polymech-info/heidenhain-simulator/cli/cad/docs/Spec.md

## OSR - CAD Policies

### Assemblies

- **Valid Formats** : STEP, Solidworks, Parasolid
