polymech-info/heidenhain-simulator/docs/670_388-20_images/670_388-20_9.md

# New Functions of Software
340 49x-03
ref_text
■ New cycle for setting a datum in the center of a slot (see "SLOT CENTER REF PT (Cycle 408, DIN/ISO: G408, FCL 3 function)" on page 333)
ref_text
■ New cycle for setting a datum in the center of a ridge (see "RIDGE CENTER REF PT (Cycle 409, DIN/ISO: G409, FCL 3 function)" on page 337)
ref_text
■ New 3-D probing cycle (see "MEASURING IN 3-D (Cycle 4, FCL 3 function)" on page 439)
ref_text
- Cycle 401 now also allows you to compensate workpiece misalignment by rotating the rotary table (see “BASIC ROTATION from two holes (Cycle 401, DIN/ISO: G401)” on page 313)
- Cycle 402 now also allows you to compensate workpiece misalignment by rotating the rotary table (see “BASIC ROTATION over two studs (Cycle 402, DIN/ISO: G402)” on page 316)
- In the cycles for datum setting, the results of measurement are available in the Q parameters Q15X (see “Measurement results in Q parameters” on page 387)

HEIDENHAIN iTNC 530
9

i
