polymech-info/heidenhain-simulator/cli/cad/tests/cas/cad/press-plate-support/400_Pressplate-lower-support.SLDASM

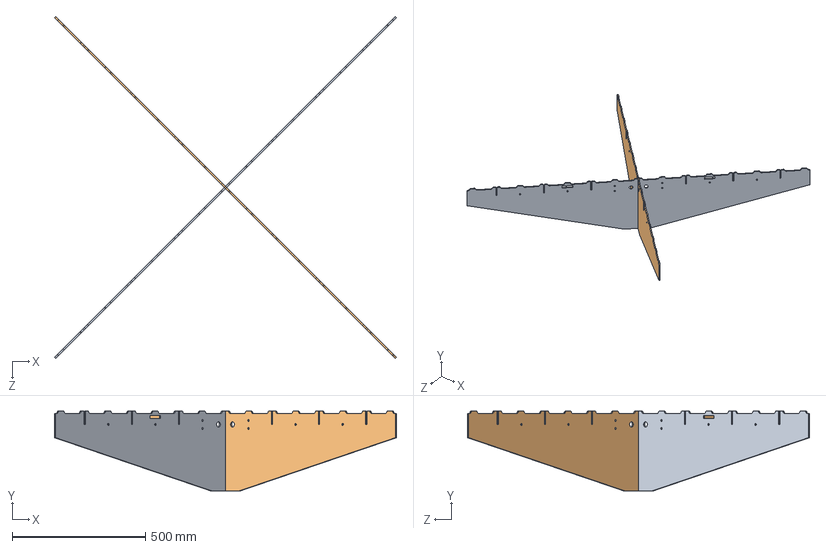
[picture p4: CAD file, 2026-09-25]
cli/cad/tests/cas/cad/press-plate-support/400_Pressplate-lower-support.SLDASM
1284.0 x 300.0 x 1284.1 mm
200_RIBA1_x1_6mm_FERRO
200_RIBA1B_x1_6mm_FERRO
