polymech-info/heidenhain-simulator/cli/cad/tests/cas/cad/sideframe/SideFrameAssembly.SLDASM

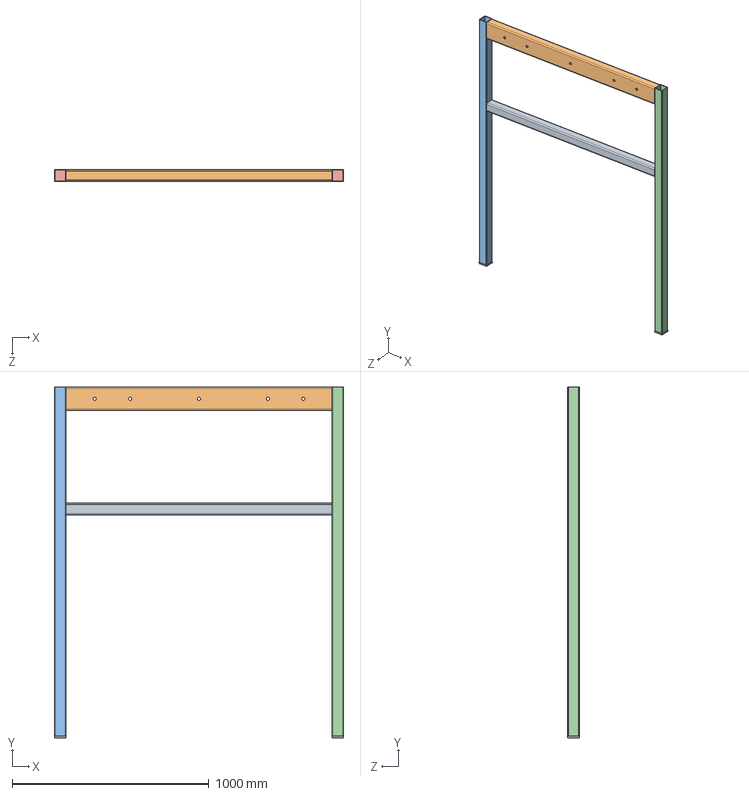
[picture p5: CAD file, 2026-09-25]
cli/cad/tests/cas/cad/sideframe/SideFrameAssembly.SLDASM
1470.0 x 1783.0 x 60.0 mm
Side Frame Midrail 80x40x840mm
303_SideFrameToprail
Leg with hood bracket cut
MirrorLeg with hood bracket cut
400_LegCover_x4_10mm_FERRO x 2
