polymech-info/heidenhain-simulator/fusion-ref/moulds/beams/Global-180x80x25_Assembly_0 v1/geometry/Global-180x80x25_Assembly_0 v1.step

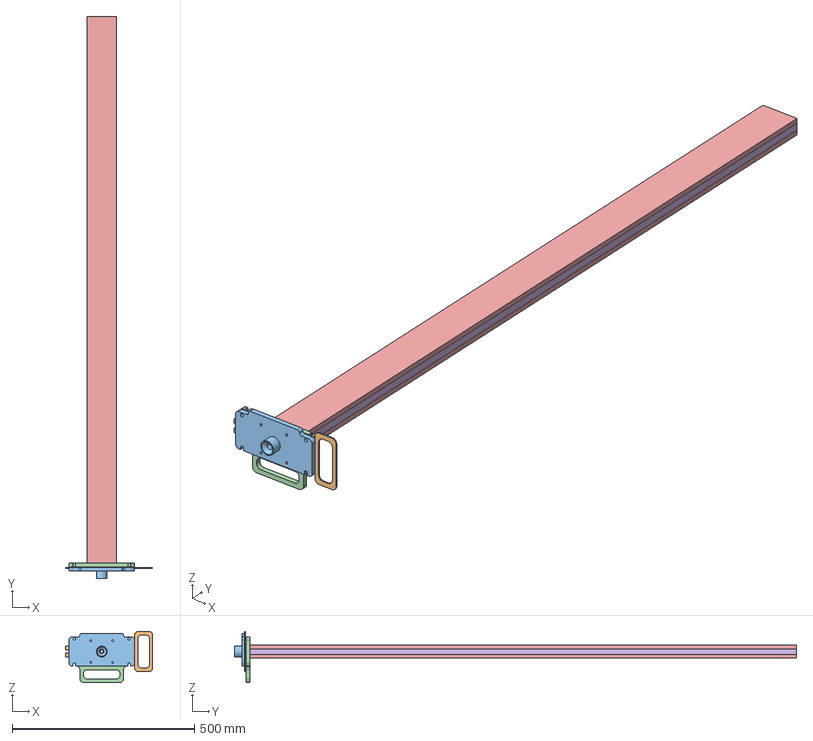
[picture p7: CAD file, 2026-09-25]
fusion-ref/moulds/beams/Global-180x80x25_Assembly_0 v1/geometry/Global-180x80x25_Assembly_0 v1.step
240.0 x 1542.0 x 140.0 mm
402_SlideCover_x2_2mm_INOX
403_SlideKey_x1_2mm_INOX
450_BeamAdapter_x1_10mm_FERRO
450_BeamMountPlate_x2_8mm_FERRO
101_Top_x2_8mm_FERRO x 2
101_Sides_x2_16mm_FERRO x 2
