polymech-info/heidenhain-simulator/fusion-ref/moulds/thomas/mould-assembly-2 v1/geometry/mould-assembly-2 v1.step

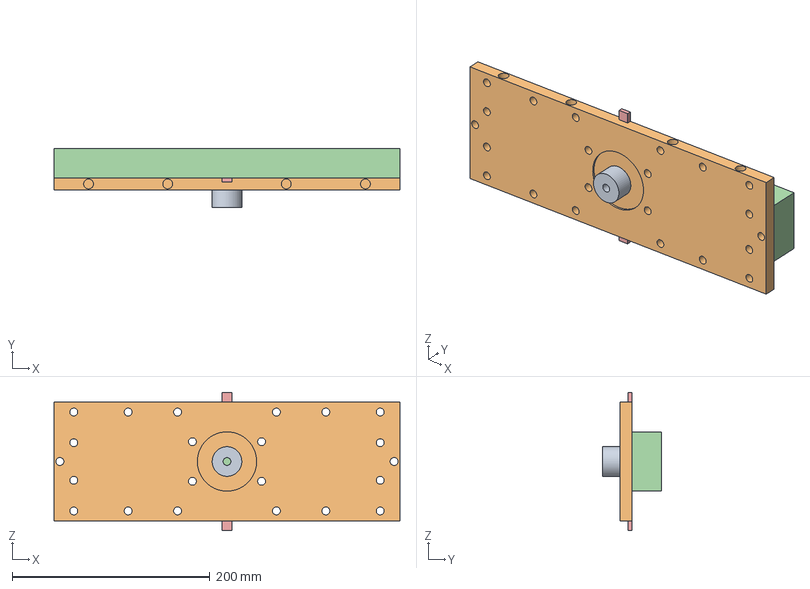
[picture p9: CAD file, 2026-09-25]
fusion-ref/moulds/thomas/mould-assembly-2 v1/geometry/mould-assembly-2 v1.step
350.0 x 60.0 x 140.0 mm
Lydia-F100-ConnectorPlate-130x130_Lydia-V3-100F
bar x 2
Bars-Upper
valve
