polymech-info/heidenhain-simulator/cli/cad/tests/cas/cad/lower-support/Global.SLDASM

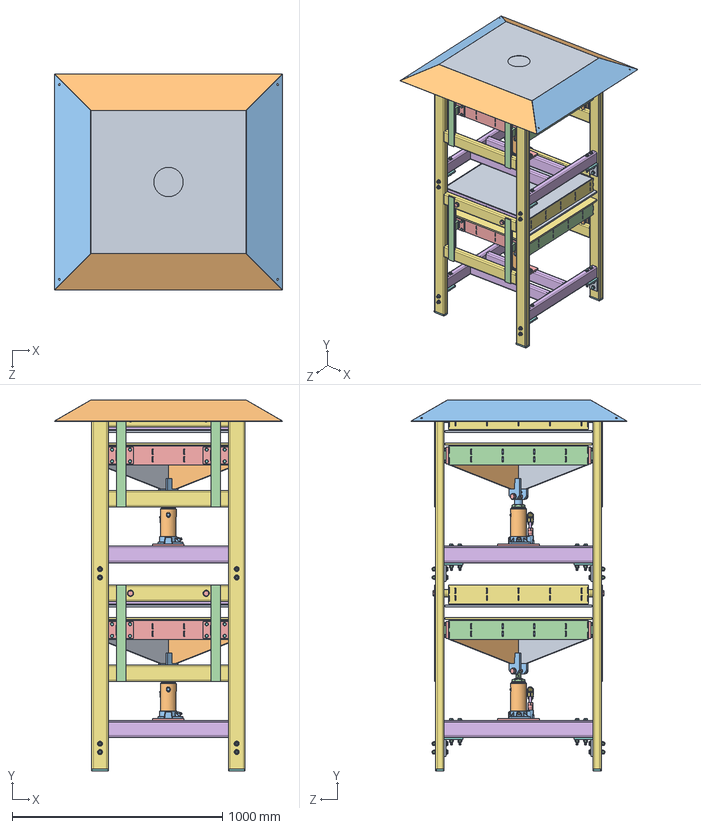
[picture p10: CAD file, 2026-09-25]
cli/cad/tests/cas/cad/lower-support/Global.SLDASM
1086.4 x 1764.3 x 1028.7 mm
HeatPlate x 2
19_Crossrib_x10_5mm_FERRO x 12
21_HeaterPlate_x8_5mm_FERRO x 8
Heater Block x 82
Heatproof Puck x 82
18_Endpanel_x4_5mm_FERRO x 4
17_Sidepanel_x4_5mm_FERRO x 4
20_Rib_x10_5mm_FERRO x 12
200_PPlateCover_x2_1mm_INOX x 2
8_Rib_x8_5mm_FERRO.DXF x 8
7_Rib_x8_5mm_FERRO.DXF x 8
7_Side_x4_5mm_FERRO.DXF x 4
6_Side_x4_5mm_FERRO.DXF x 4
10_HeaterBack_x10_5mm_FERRO.DXF x 10
EMP_054_Heatplate_Light_x2_10.0mm_Inox x 2
EMP_058_Heatplate_Mount_Light_x4_10.0mm_Inox x 2
1_RibA_x1_10mm_FERRO x 2
2_RibB_x1_10mm_FERRO x 2
3_Mount_x2_10mm_FERRO x 4
SBR20UU x 8
11_Mount_x8_10mm_FERRO x 8
socket countersunk head screw_din x 32
plain washer grade a_din x 32
hex bolt gradeb_din x 64
201_PlateCoverTri_x8_1mm_FERRO x 8
SBS 20 Rail 200mm x 8
Bottle Jack Base x 2
Valve Ball x 4
Pump washer-gasket x 2
Plastic Stop x 2
Valve Bolt x 2
Valve Bolt Dowel x 2
O-Ring - 11 OD x 2
Jack Barrel x 2
Jack Piston x 2
Power Screw x 2
Jack Piston - O-Ring x 2
Jack Piston - Back-up Ring x 2
Pump Lever x 2
Pump Lever Linkage Connector Pin x 2
reinforced e-ring external retaining ring_am x 10
Pump Lever Main Connector Pin x 2
Pump Lever Linkage x 4
Pump Lever Linkage Base Connector Shaft x 2
Pump Barrel x 2
Pump Piston x 2
Pump Barrel - Gasket x 2
Pump Piston - O-Ring x 2
Pump - Back-up Ring x 2
Bottle Jack Housing x 2
Rubber Relief-Filler x 2
Retaining Nut x 2
15_JMPlate_x1_10mm_FERRO x 2
Bottom Frame x 2
Side Frame x 2
30_Bracket1_x8_10mm_FERRO x 8
31_Bracket2_x8_10mm_FERRO x 8
plain washer 6902 type abc_din x 64
plain washer grade c_din x 20
prevailing torque nut style 1 insert_din x 34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
