polymech-info/heidenhain-simulator/cli/cad/tests/cas/cad/press-frame-2/Lower Platen Matrix Assembly Light.SLDASM

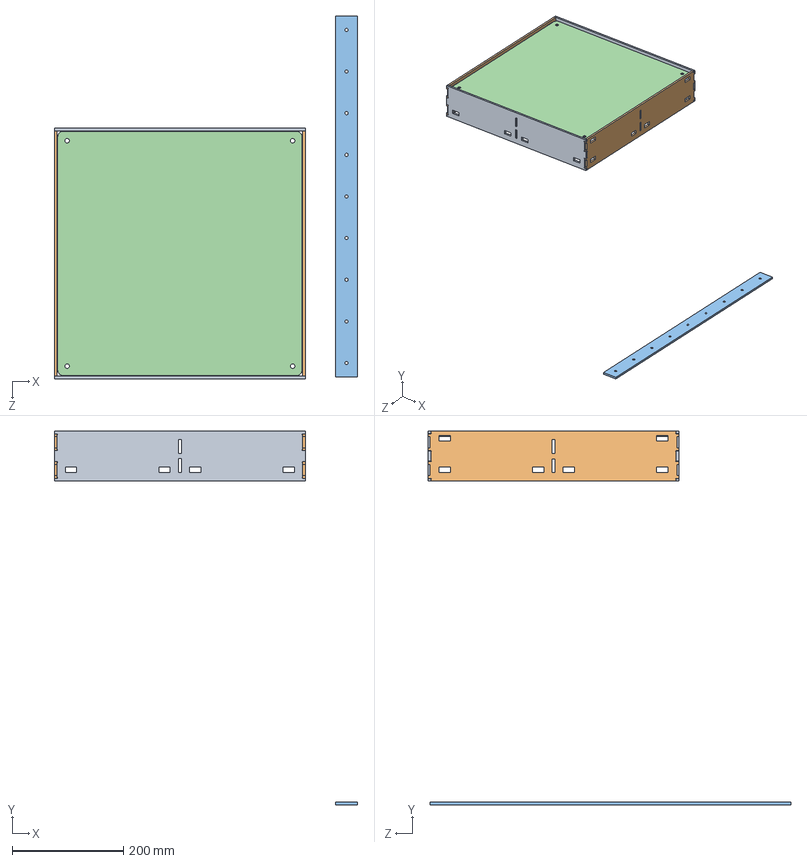
[picture p11: CAD file, 2026-09-25]
cli/cad/tests/cas/cad/press-frame-2/Lower Platen Matrix Assembly Light.SLDASM
546.1 x 673.2 x 653.7 mm
7_Side_x4_5mm_FERRO.DXF x 2
6_Side_x4_5mm_FERRO.DXF x 2
202_PlateCover_x2_1mm_INOX
