polymech-info/heidenhain-simulator/cli/cad/tests/cas/cad/lower-structure/Lower-Structure.SLDASM

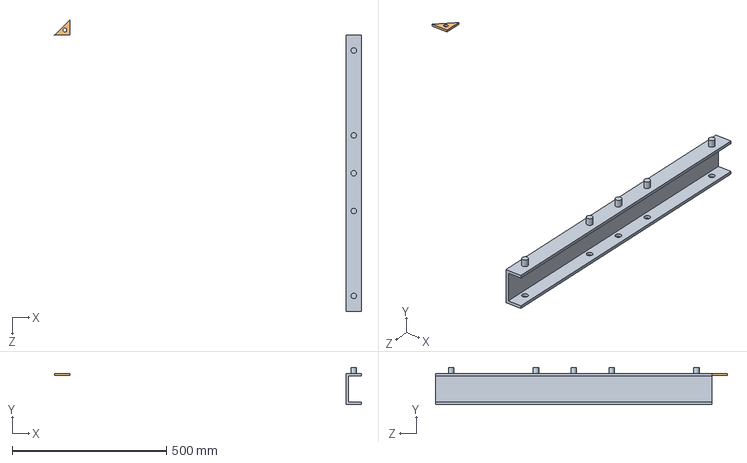
[picture p12: CAD file, 2026-09-25]
cli/cad/tests/cas/cad/lower-structure/Lower-Structure.SLDASM
995.0 x 120.0 x 945.0 mm
Beam
Part1^Lower-Structure
