polymech-info/heidenhain-simulator/cli/cad/tests/cas/cad/press-plate-support/301_LowerRibs.SLDASM

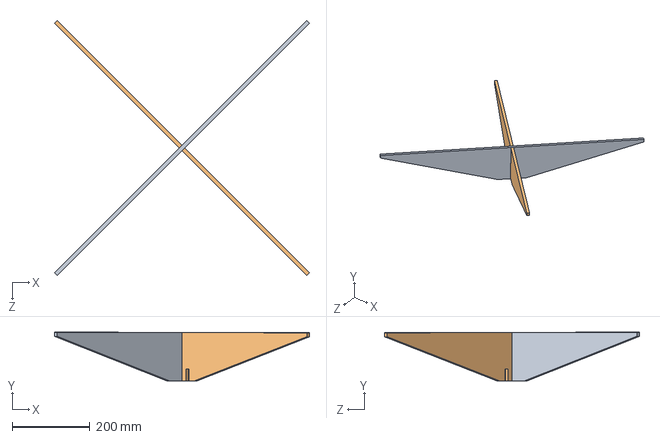
[picture p13: CAD file, 2026-09-25]
cli/cad/tests/cas/cad/press-plate-support/301_LowerRibs.SLDASM
658.0 x 126.2 x 658.0 mm
302_RibA_x1_10mm_FERRO
302_RibB_x1_10mm_FERRO
