polymech-info/heidenhain-simulator/cli/cad/tests/cabinet/EDC-Tests.SLDASM

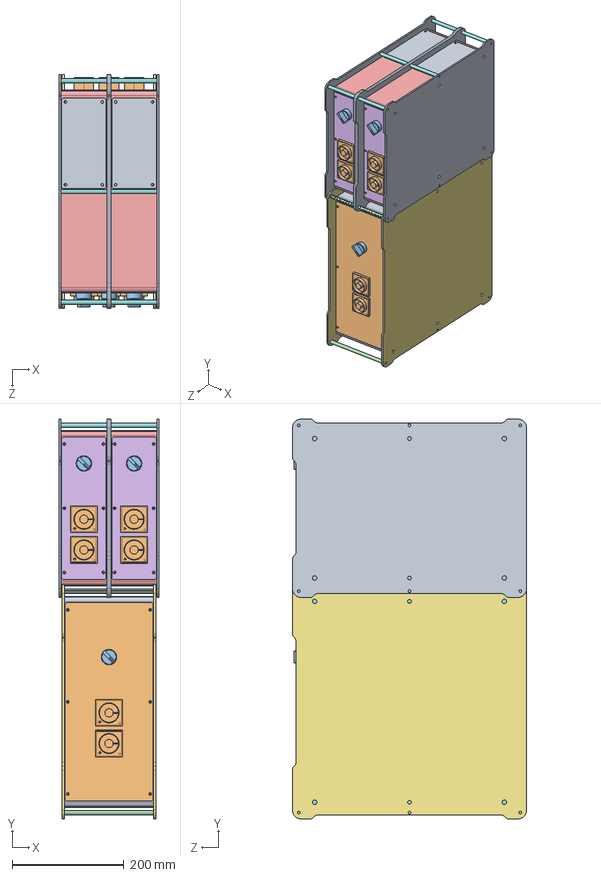
[picture p14: CAD file, 2026-09-25]
cli/cad/tests/cabinet/EDC-Tests.SLDASM
180.0 x 717.0 x 420.0 mm
403_MountPlate_x2_4mm_INOX x 4
E5C2 x 6
3Pos-Switch-22mm x 3
530_BasePost x 12
525_Belt_x1_1mm_INOX x 2
610_FrontPanel_x1_1mm_INOX x 2
611_BackPanel_x2_1mm_INOX x 4
540_SupportHookPins_x6_8mm_INOX x 12
612_SidePanel_x2_1mm_INOX x 4
MCB-2P x 6
Circuit breaker Schneider Electric BA63.STEP x 3
Plastic overlay.STEP x 3
Latch.STEP x 3
Lever arm.STEP x 3
803_MountPlate_x2_4mm_INOX x 2
830_BasePost x 6
825_Belt_x1_1mm_INOX
810_FrontPanel_x1_1mm_INOX
811_BackPanel_x2_1mm_INOX x 2
840_SupportHookPins_x6_8mm_INOX x 6
812_SidePanel_x2_1mm_INOX x 2
