polymech-info/heidenhain-simulator/cli/cad/tests/cabinet/packed/CAM-SidePanel.SLDASM

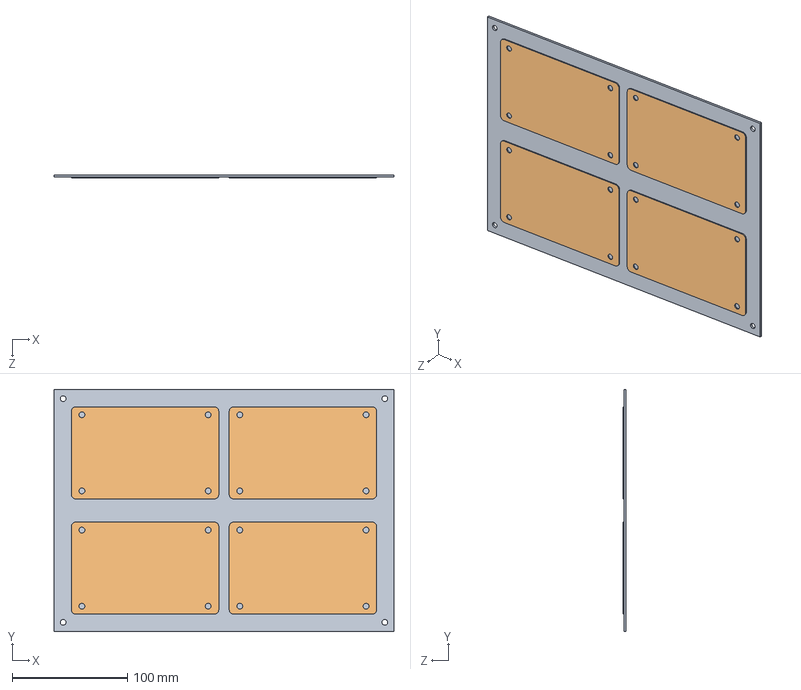
[picture p15: CAD file, 2026-09-25]
cli/cad/tests/cabinet/packed/CAM-SidePanel.SLDASM
295.0 x 210.0 x 3.00 mm
Panels-Sheet-Stock-A4
611_BackPanel_x2_1mm_INOX x 4
