polymech-info/heidenhain-simulator/cli/cad/tests/cas/cad/400_Pressplate-lower-support.SLDASM

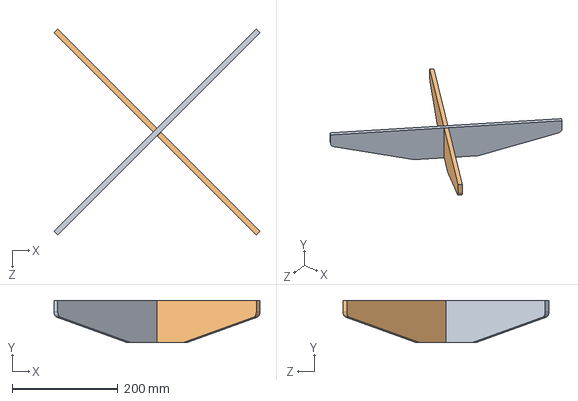
[picture p16: CAD file, 2026-09-25]
cli/cad/tests/cas/cad/400_Pressplate-lower-support.SLDASM
390.0 x 80.0 x 390.1 mm
200_RIBA1_x2_10mm_FERRO
200_RIBA1B_x2_10mm_FERRO
