polymech-info/heidenhain-simulator/cli/cad/tests/cas/cad/press-frame-2/200_Bottom-PressPlate.SLDASM

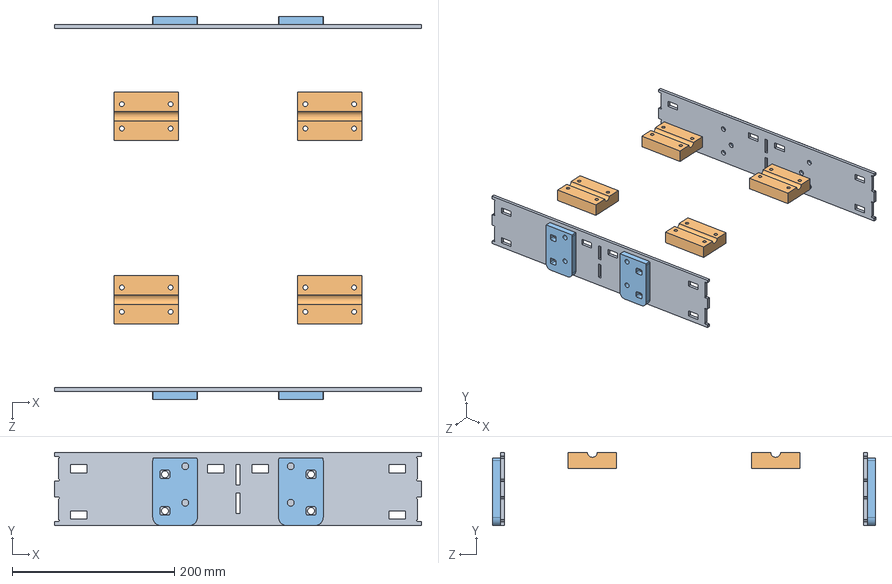
[picture p17: CAD file, 2026-09-25]
cli/cad/tests/cas/cad/press-frame-2/200_Bottom-PressPlate.SLDASM
452.0 x 90.0 x 471.8 mm
7_Side_x2_5mm_FERRO.DXF x 2
405_BearingMount_x8_8mm_FERRO x 4
