polymech-info/heidenhain-simulator/cli/cad/tests/cas/cad/sideframe/GlobalAssembly.SLDASM

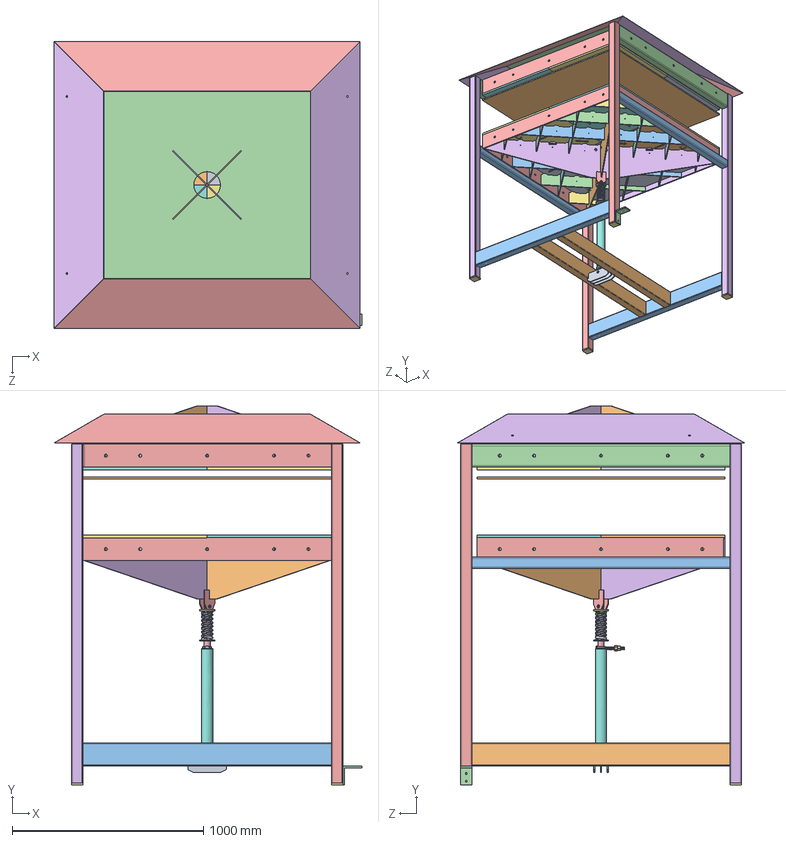
[picture p18: CAD file, 2026-09-25]
cli/cad/tests/cas/cad/sideframe/GlobalAssembly.SLDASM
1611.0 x 1983.0 x 1502.0 mm
26_JackMount_x3_6mm_Ferro x 4
Base Frame Crossmember x 2
Base Frame Rail x 2
SPR-V1 4000.01-A Spring sleeve
SPR-V1 4000.02-A Spring rod
SPR-V1 4000.012 Spring flange upper
SPR-V1 4000.01 Spring flange lower
SPR-V1 15 Die Spring_96485K331
hex nut gradec_iso_ISO - 4034 - M16 - N x 2
hex bolt gradeab_iso_ISO 4014 - M16 x 140 x 140-S
SPR-V1 01 Jack rod
SP1.0_025_Jack_Mount Upper_x2_6.0mm_Inox x 2
200_RIBA1_x1_6mm_FERRO x 2
200_RIBA4_x4_6mm_FERRO x 8
200_RIBA2_x2_6mm_FERRO x 4
200_RIBA3_x2_6mm_FERRO x 4
200_RIBA1B_x1_6mm_FERRO x 2
200_RIBA2B_x2_6mm_FERRO x 4
200_RIBA3B_x2_6mm_FERRO x 4
300_BAR_x4_8mm_FERRO x 6
MirrorPlaten End x 2
sp-partition-tl x 2
sp-partition-tr x 2
sp-partition-bl x 2
sp-partition-br x 2
Side Frame Midrail 80x40x840mm x 2
303_SideFrameToprail x 2
Leg with hood bracket cut x 2
MirrorLeg with hood bracket cut x 2
400_LegCover_x4_10mm_FERRO x 4
SPR-V1 01 Cylinder
400_Mount_4x_6mm_FERRO
603_Centerpanel_x1_2mm_Ferro
602_Endpanel_x1_2mm_Ferro x 2
604_Sidepanel_x1_2mm_Ferro x 2
