polymech-info/heidenhain-simulator/cli/cad/tests/cabinet/CAB-2PID-VintageVertical.SLDASM

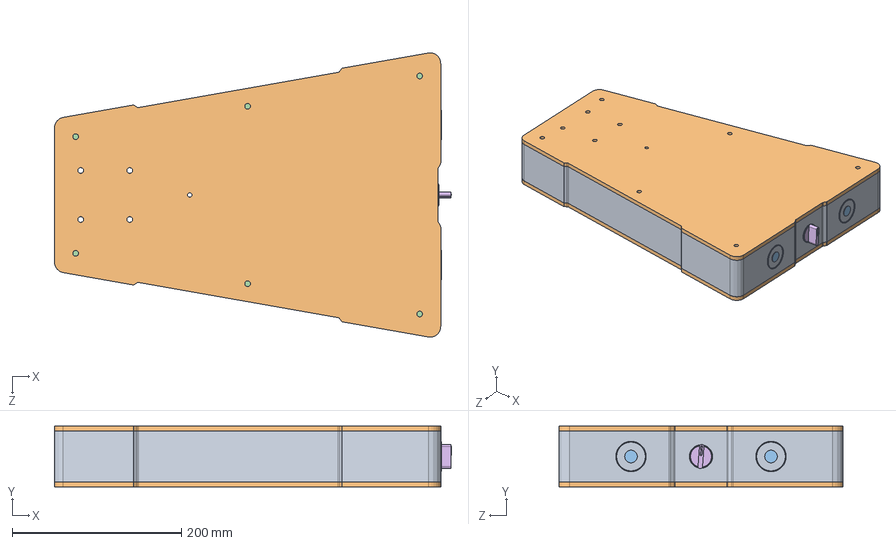
[picture p19: CAD file, 2026-09-25]
cli/cad/tests/cabinet/CAB-2PID-VintageVertical.SLDASM
469.7 x 72.0 x 336.3 mm
520_Belt_x2_1mm_INOX
403_MountPlate_x2_6mm_INOX x 2
E5C2 x 2
530_BasePost x 6
540_MiddlePlate_x2_1mm_INOX x 2
3Pos-Switch-22mm
socket button head cap screw_amxxx x 6
