polymech-info/heidenhain-simulator/cli/cad/tests/cas/cad/press-frame/TopPress-Plate.SLDASM

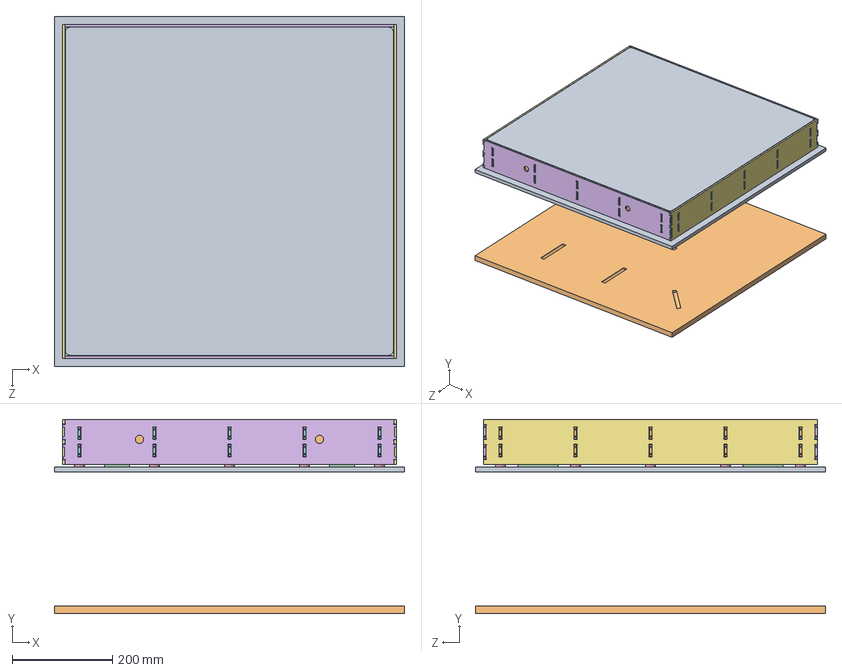
[picture p20: CAD file, 2026-09-25]
cli/cad/tests/cas/cad/press-frame/TopPress-Plate.SLDASM
700.0 x 388.6 x 700.0 mm
19_Crossrib_x10_5mm_FERRO x 6
Heater Block
Heatproof Puck x 25
18_Endpanel_x4_5mm_FERRO x 2
17_Sidepanel_x4_5mm_FERRO x 2
20_Rib_x10_5mm_FERRO x 6
200_PPlateCover_x2_1mm_INOX
sp-artition-cell
