polymech-info/heidenhain-simulator/cli/cad/tests/cabinet/packed/Cabinet-EDC-Flex.SLDASM

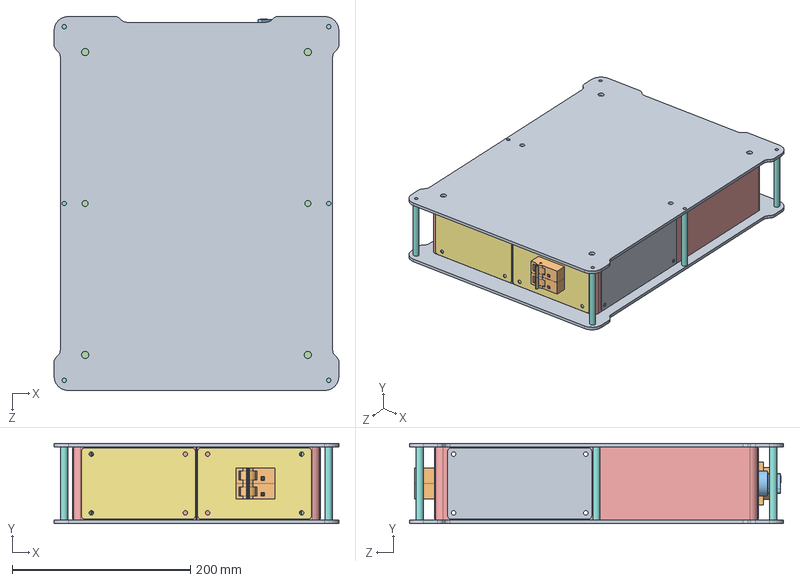
[picture p21: CAD file, 2026-09-25]
cli/cad/tests/cabinet/packed/Cabinet-EDC-Flex.SLDASM
320.0 x 90.0 x 420.0 mm
403_MountPlate_x2_4mm_INOX x 2
E5C2 x 2
3Pos-Switch-22mm
530_BasePost x 6
525_Belt_x1_1mm_INOX
610_FrontPanel_x1_1mm_INOX
611_BackPanel_x2_1mm_INOX x 2
540_SupportHookPins_x6_8mm_INOX x 6
612_SidePanel_x2_1mm_INOX x 2
MCB-2P x 2
Circuit breaker Schneider Electric BA63.STEP
Plastic overlay.STEP
Latch.STEP
Lever arm.STEP
