polymech-info/heidenhain-simulator/cli/cad/tests/cabinet/500_Base.SLDASM

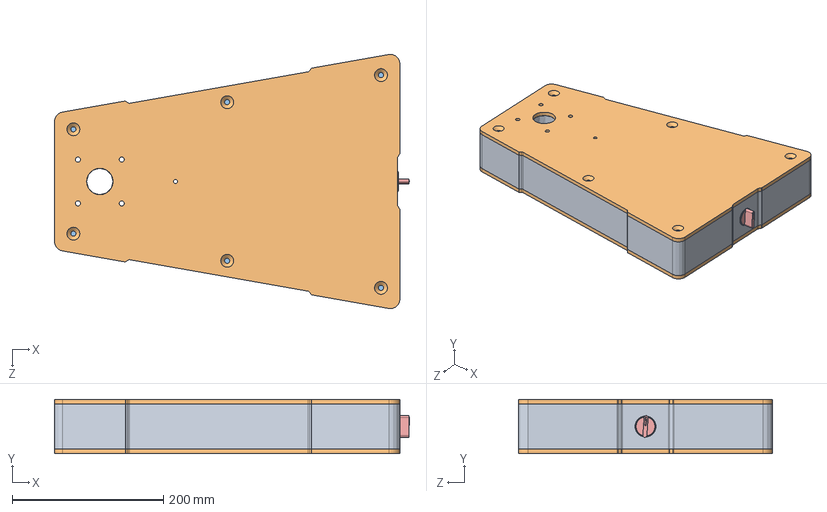
[picture p22: CAD file, 2026-09-25]
cli/cad/tests/cabinet/500_Base.SLDASM
469.7 x 72.0 x 336.3 mm
520_Belt_x2_1mm_INOX
403_MountPlate_x2_5mm_INOX x 2
530_BasePost^500_Base x 6
540_MiddlePlate_x2_1mm_INOX x 2
3Pos-Switch-22mm
