polymech-info/heidenhain-simulator/cli/cad/tests/cas/cad/600_Enclosure.SLDASM

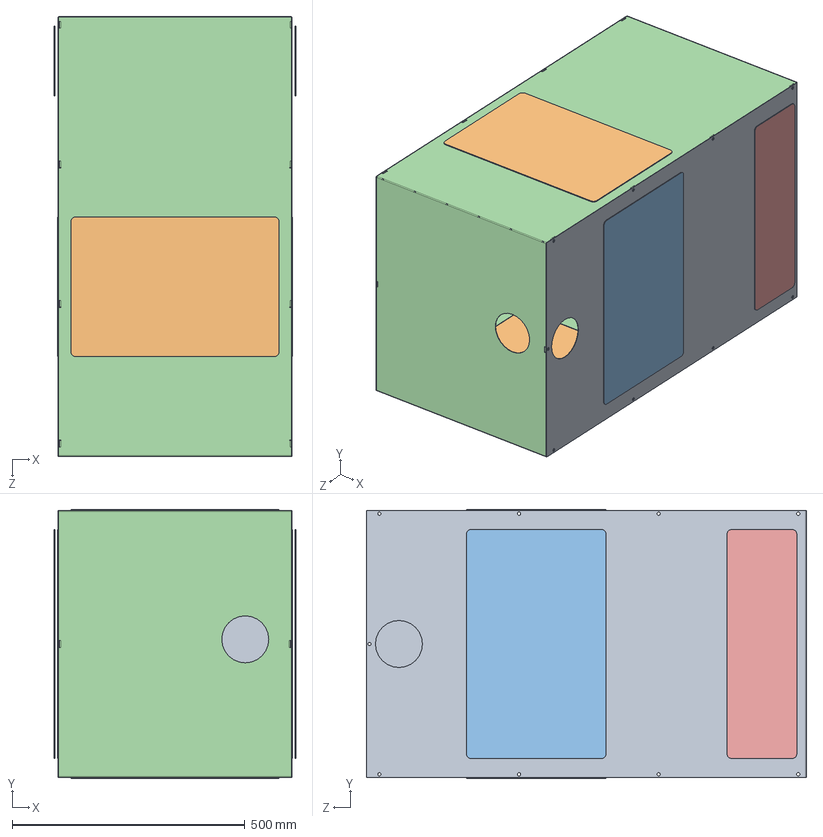
[picture p23: CAD file, 2026-09-25]
cli/cad/tests/cas/cad/600_Enclosure.SLDASM
519.5 x 578.0 x 946.0 mm
102_Bottom2_x1_2mm_INOX
502_SideDoor_x2_2mm_INOX x 2
501_FrontDoor_x2_2mm_INOX x 2
102_Top_2mm_INOX
504_BottomDoor_x2_2mm_INOX x 2
