polymech-info/heidenhain-simulator/cli/cad/tests/cas/cad/Framework.SLDASM

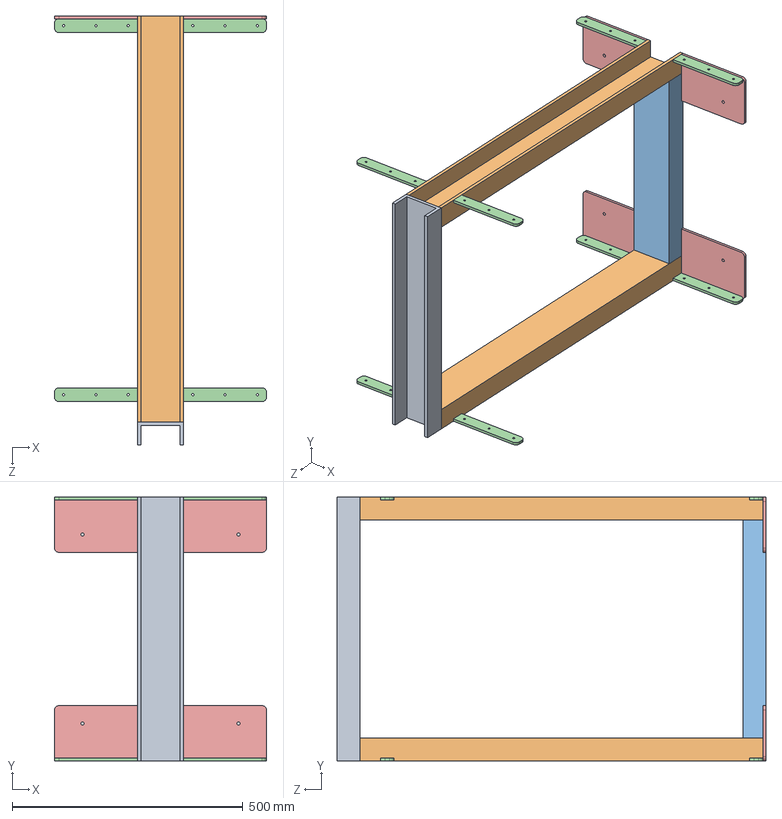
[picture p24: CAD file, 2026-09-25]
cli/cad/tests/cas/cad/Framework.SLDASM
460.0 x 572.0 x 930.0 mm
100_50_BeamTop
100_50_Beam x 2
100_50_BeamBottom
801_EncTopMount_x4_5mm_FERRO x 8
802_EncBottomMount_x4_6mm_FERRO x 4
