polymech-info/heidenhain-simulator/cli/cad/tests/cabinet/540_SupportHookPins_x6_8mm_INOX.SLDPRT

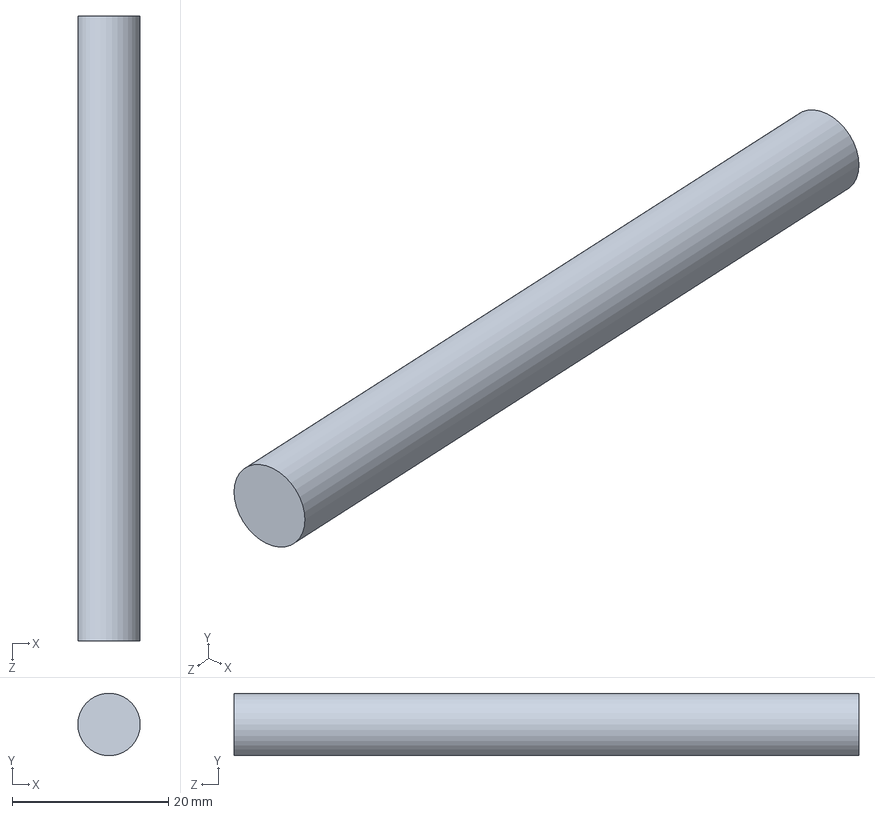
[picture p25: CAD file, 2026-09-25]
cli/cad/tests/cabinet/540_SupportHookPins_x6_8mm_INOX.SLDPRT
8.00 x 7.97 x 80.0 mm
