polymech-info/heidenhain-simulator/cli/cad/tests/cas/cad/504_BottomDoor_x2_2mm_INOX.SLDPRT

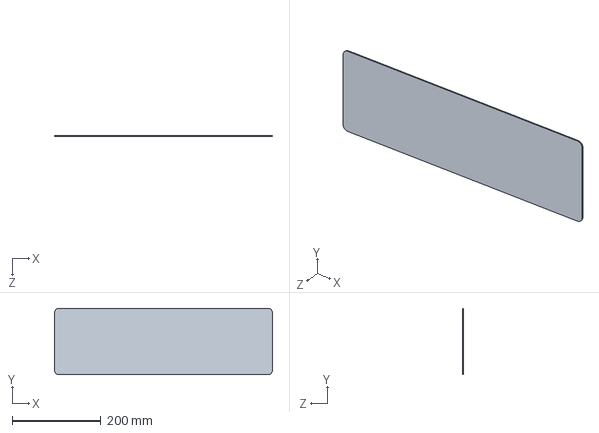
[picture p26: CAD file, 2026-09-25]
cli/cad/tests/cas/cad/504_BottomDoor_x2_2mm_INOX.SLDPRT
492.0 x 150.0 x 2.00 mm
