polymech-info/heidenhain-simulator/cli/cad/tests/cas/cad/enclosure/102_Top_2mm_INOX.SLDPRT

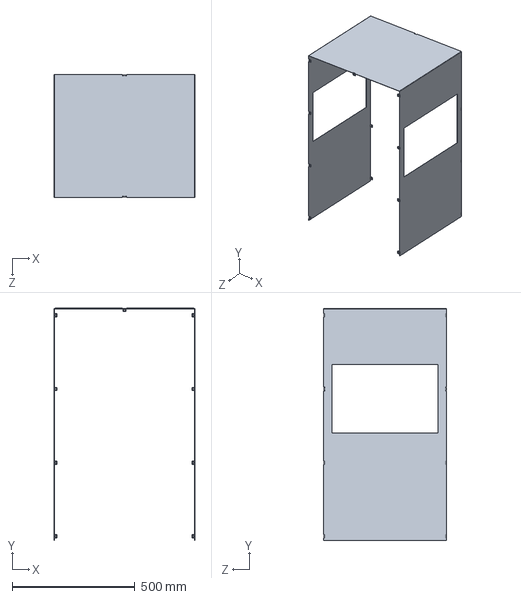
[picture p27: CAD file, 2026-09-25]
cli/cad/tests/cas/cad/enclosure/102_Top_2mm_INOX.SLDPRT
574.0 x 945.0 x 500.0 mm
