polymech-info/heidenhain-simulator/cli/cad/tests/cas/cad/enclosure/laser/102_Bottom2_x1_2mm_INOX.DXF

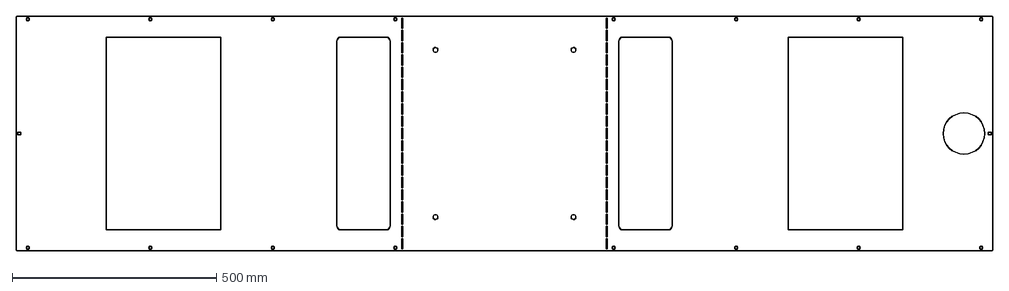
[picture p28: CAD file, 2026-09-25]
cli/cad/tests/cas/cad/enclosure/laser/102_Bottom2_x1_2mm_INOX.DXF
2390.7 x 574.0 mm
