polymech-info/heidenhain-simulator/cli/cad/tests/cas/cad/laser/200_RIBA1B_x2_10mm_FERRO.DXF

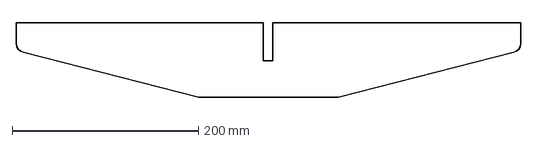
[picture p29: CAD file, 2026-09-25]
cli/cad/tests/cas/cad/laser/200_RIBA1B_x2_10mm_FERRO.DXF
541.5 x 80.0 mm
