polymech-info/heidenhain-simulator/cli/cad/tests/cas/cad/lower-structure/100_50_BeamBottom.SLDPRT

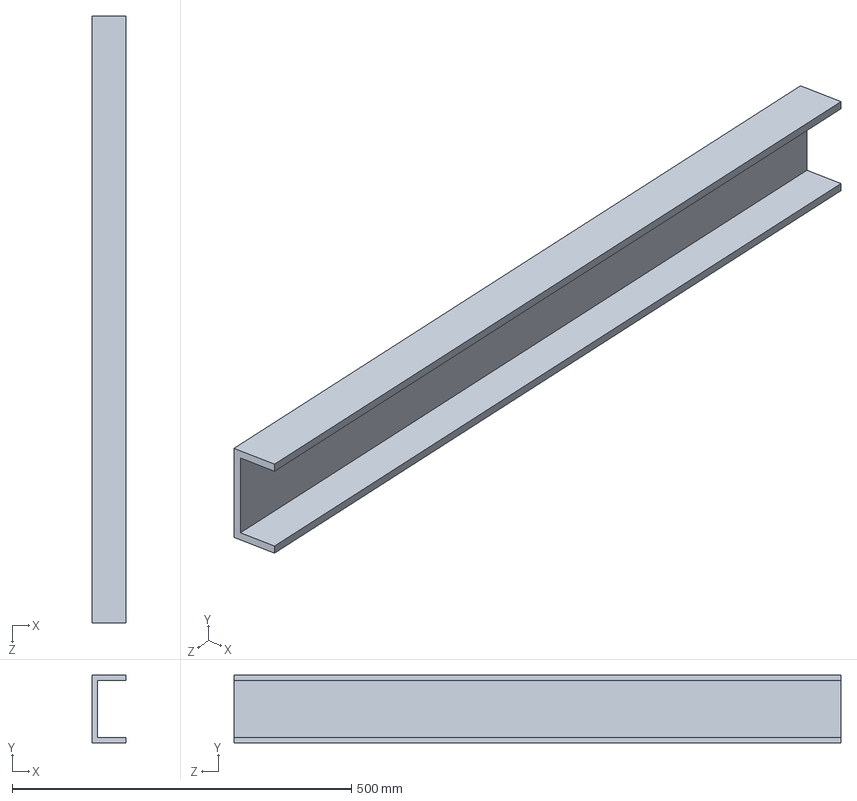
[picture p30: CAD file, 2026-09-25]
cli/cad/tests/cas/cad/lower-structure/100_50_BeamBottom.SLDPRT
50.0 x 100.0 x 895.0 mm
