polymech-info/heidenhain-simulator/cli/cad/tests/cas/cad/lower-support/Bottom Frame.SLDPRT

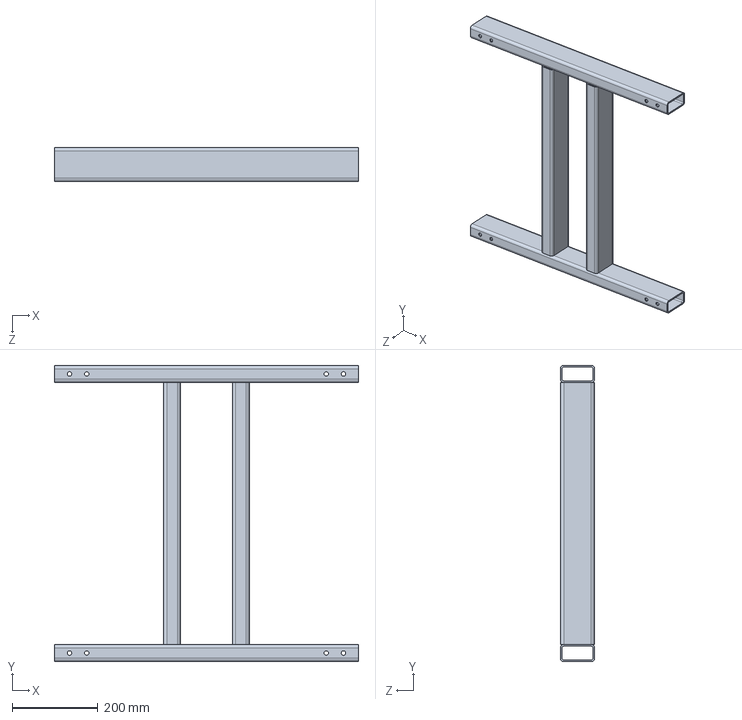
[picture p31: CAD file, 2026-09-25]
cli/cad/tests/cas/cad/lower-support/Bottom Frame.SLDPRT
708.0 x 690.0 x 80.0 mm
