polymech-info/heidenhain-simulator/cli/cad/tests/cas/cad/press-frame-2/7_Side_x2_5mm_FERRO.DXF.SLDPRT

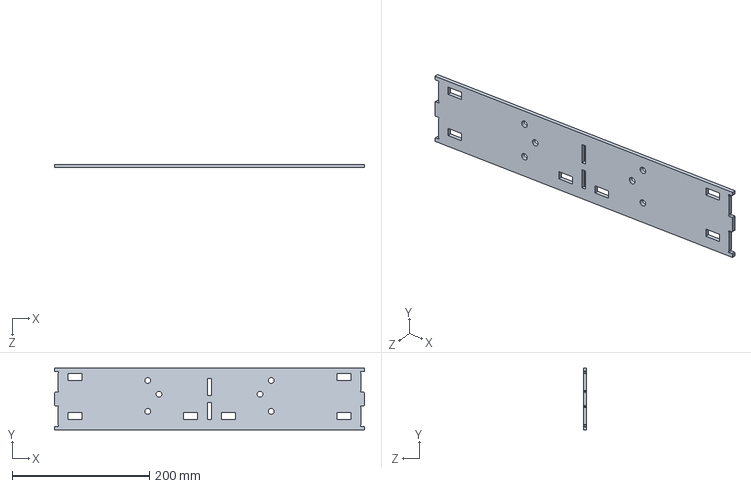
[picture p32: CAD file, 2026-09-25]
cli/cad/tests/cas/cad/press-frame-2/7_Side_x2_5mm_FERRO.DXF.SLDPRT
452.0 x 90.0 x 5.00 mm
