polymech-info/heidenhain-simulator/cli/cad/tests/cas/cad/press-frame/17_Sidepanel_x4_5mm_FERRO.SLDPRT

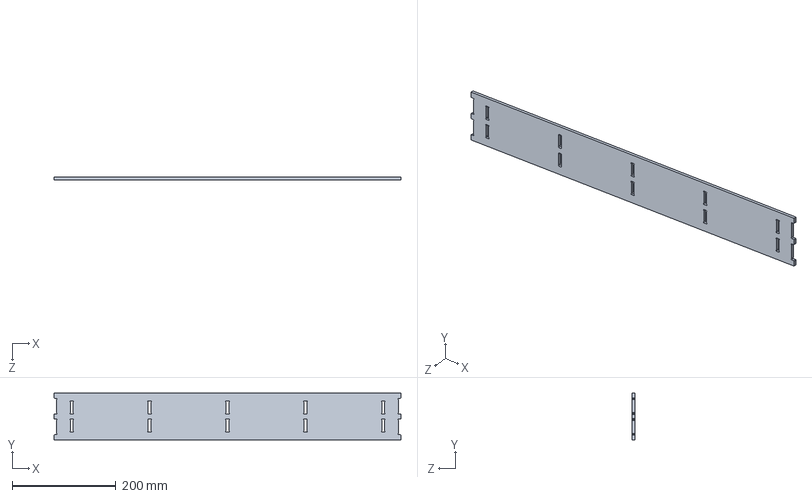
[picture p33: CAD file, 2026-09-25]
cli/cad/tests/cas/cad/press-frame/17_Sidepanel_x4_5mm_FERRO.SLDPRT
668.0 x 90.0 x 5.00 mm
