polymech-info/heidenhain-simulator/cli/cad/tests/cas/cad/press-frame/laser-one/18_Endpanel_x2_5mm_FERRO.DXF

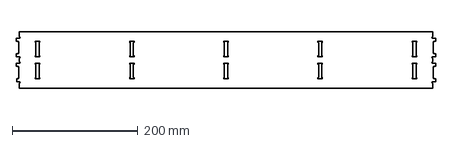
[picture p34: CAD file, 2026-09-25]
cli/cad/tests/cas/cad/press-frame/laser-one/18_Endpanel_x2_5mm_FERRO.DXF
668.0 x 90.0 mm
