polymech-info/heidenhain-simulator/cli/cad/tests/cas/cad/press-frame/laser/19_Crossrib_x10_5mm_FERRO.DXF

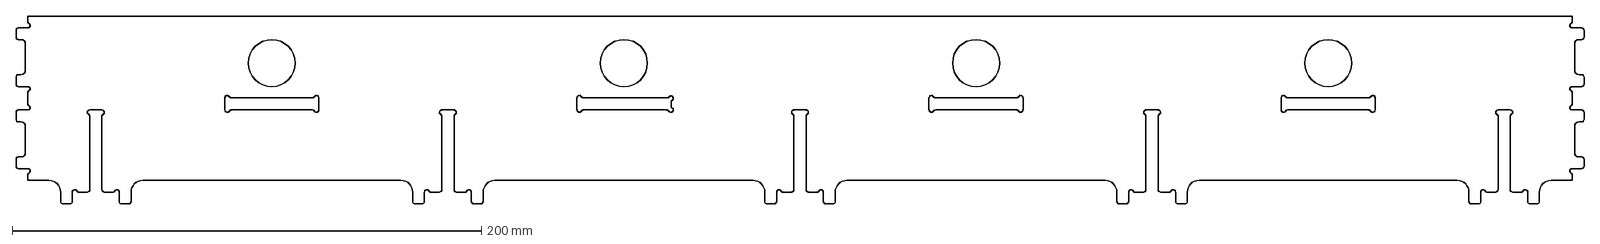
[picture p35: CAD file, 2026-09-25]
cli/cad/tests/cas/cad/press-frame/laser/19_Crossrib_x10_5mm_FERRO.DXF
668.0 x 80.0 mm
