polymech-info/heidenhain-simulator/cli/cad/tests/cas/cad/press-plate/903_Triangle_x12_6mm_Ferro.SLDPRT

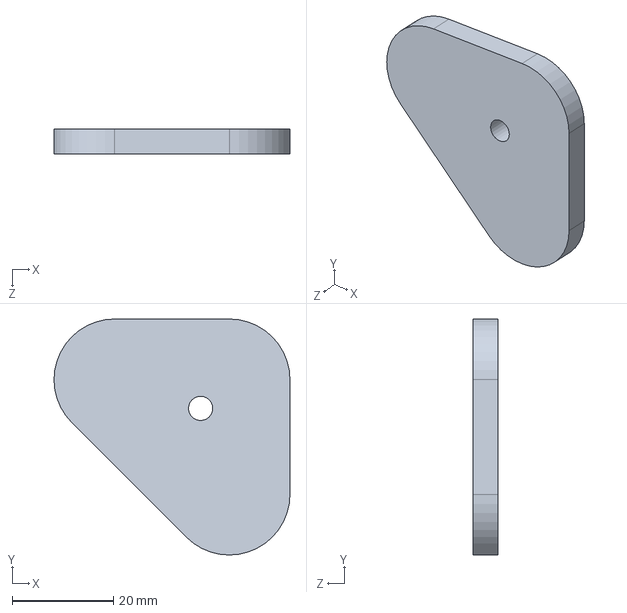
[picture p36: CAD file, 2026-09-25]
cli/cad/tests/cas/cad/press-plate/903_Triangle_x12_6mm_Ferro.SLDPRT
46.7 x 46.7 x 5.00 mm
