polymech-info/heidenhain-simulator/cli/cad/tests/drive/400_Drive.step

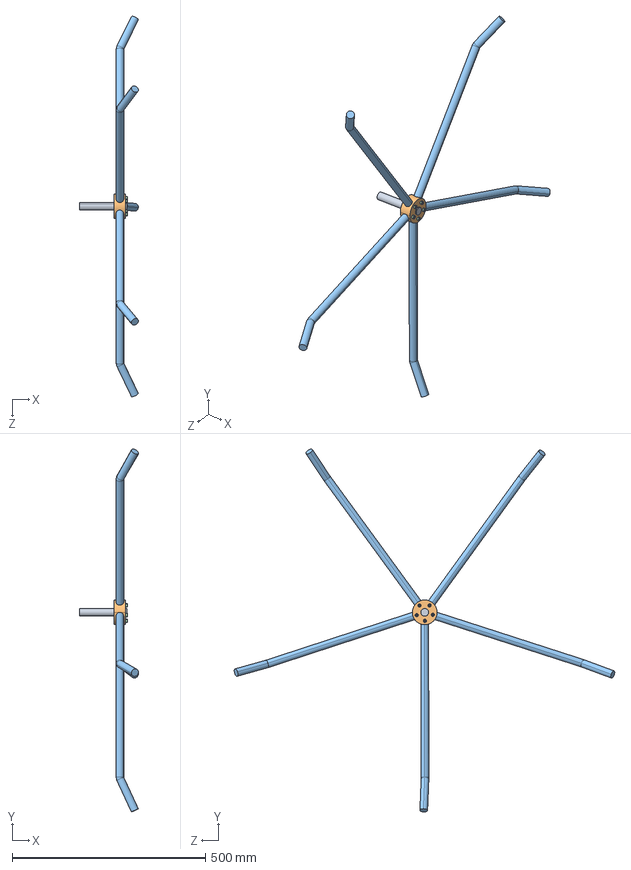
[picture p37: CAD file, 2026-09-25]
cli/cad/tests/drive/400_Drive.step
152.0 x 939.2 x 984.7 mm
HubAxle_Central Axis - 180mm
HandleMount
Round_Bar_Handle_Handle_length-600mm x 5
socket head cap screw_am_B18.3.1M - 5 x 0.8 x 20 Hex SHCS -- 20NHX x 5
