polymech-info/heidenhain-simulator/cli/cad/tests/print/Global.3mf

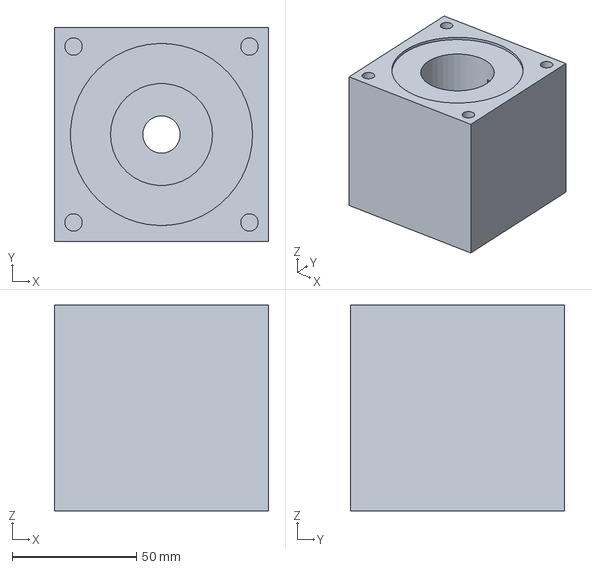
[picture p38: CAD file, 2026-09-25]
cli/cad/tests/print/Global.3mf
86.0 x 86.0 x 82.7 mm
