polymech-info/heidenhain-simulator/fusion-ref/components/405_FlangeRect_x1_10mm_FERRO v1/geometry/405_FlangeRect_x1_10mm_FERRO v1.step

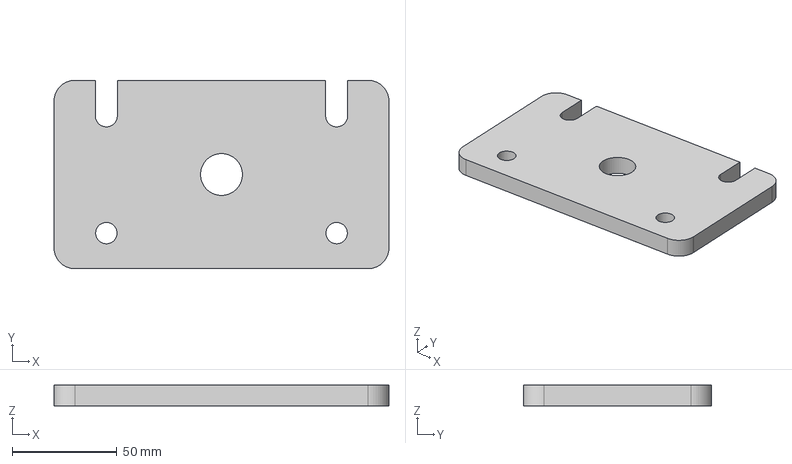
[picture p39: CAD file, 2026-09-25]
fusion-ref/components/405_FlangeRect_x1_10mm_FERRO v1/geometry/405_FlangeRect_x1_10mm_FERRO v1.step
160.0 x 90.0 x 10.0 mm
