polymech-info/heidenhain-simulator/fusion-ref/components/clutch v1/geometry/clutch v1.step

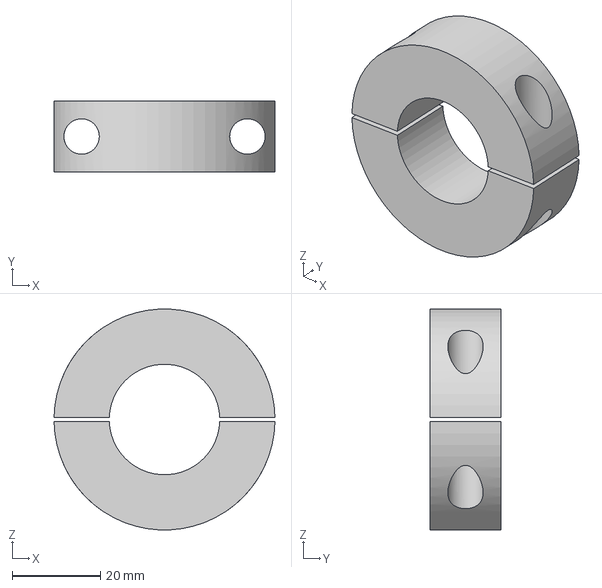
[picture p40: CAD file, 2026-09-25]
fusion-ref/components/clutch v1/geometry/clutch v1.step
50.0 x 16.0 x 49.9 mm
