polymech-info/heidenhain-simulator/fusion-ref/components/hopper-mount/512_HopperStepperMount v1/geometry/512_HopperStepperMount v1.step

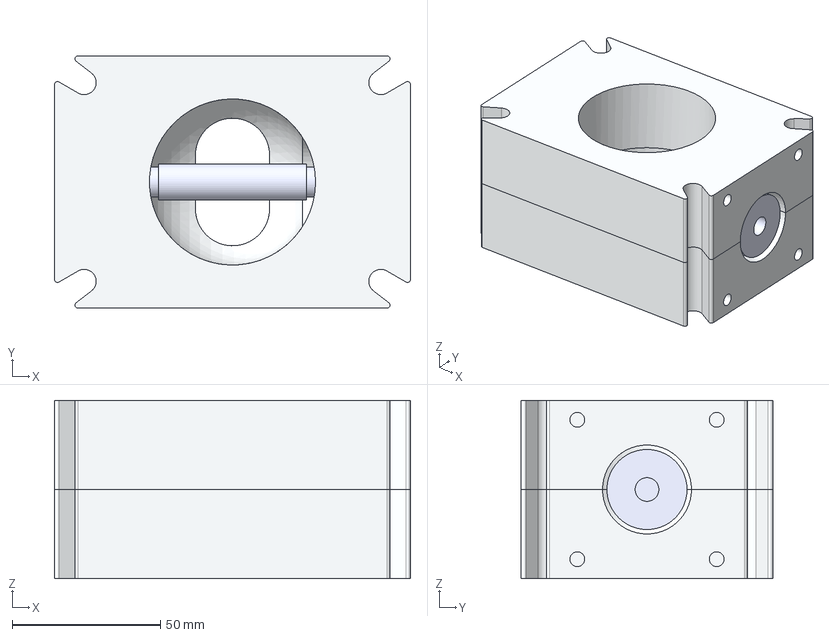
[picture p41: CAD file, 2026-09-25]
fusion-ref/components/hopper-mount/512_HopperStepperMount v1/geometry/512_HopperStepperMount v1.step
120.0 x 85.0 x 60.0 mm
512_HopperStepperMount-85-115-40d-30h_Bottom
512_HopperStepperMount-85-115-40d-30h_Top
Coupling_M8-25D-30H
Nema-23-Feedscrew
