polymech-info/heidenhain-simulator/fusion-ref/components/hopper-mount/512_HopperStepperMount-85-115-40d-30h v1/geometry/512_HopperStepperMount-85-115-40d-30h v1.step

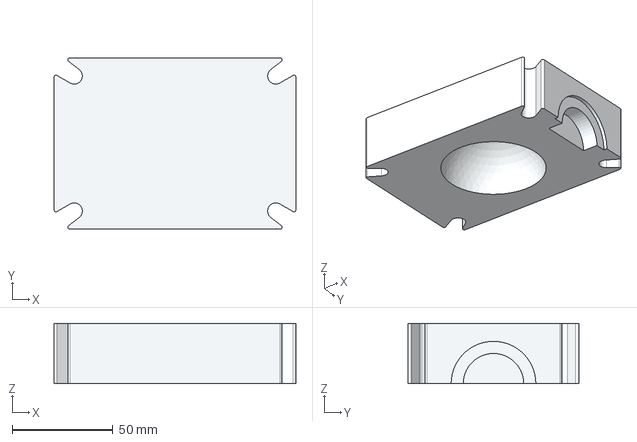
[picture p42: CAD file, 2026-09-25]
fusion-ref/components/hopper-mount/512_HopperStepperMount-85-115-40d-30h v1/geometry/512_HopperStepperMount-85-115-40d-30h v1.step
120.0 x 85.0 x 30.0 mm
