polymech-info/heidenhain-simulator/fusion-ref/components/hopper-mount/516_TurretBase-30H-85-115 v1/geometry/516_TurretBase-30H-85-115 v1.step

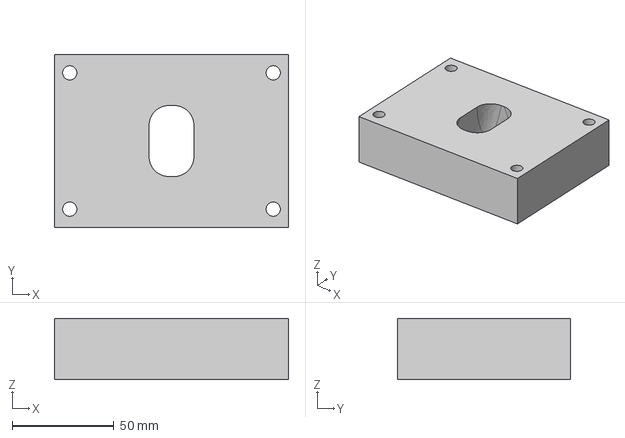
[picture p43: CAD file, 2026-09-25]
fusion-ref/components/hopper-mount/516_TurretBase-30H-85-115 v1/geometry/516_TurretBase-30H-85-115 v1.step
115.0 x 85.0 x 30.0 mm
