polymech-info/heidenhain-simulator/fusion-ref/components/Logo v2/geometry/Logo v2.step

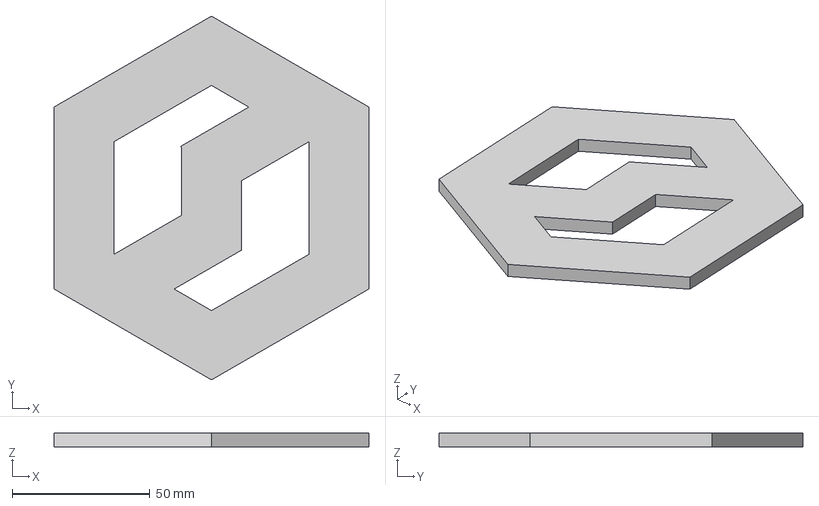
[picture p44: CAD file, 2026-09-25]
fusion-ref/components/Logo v2/geometry/Logo v2.step
114.5 x 132.3 x 5.00 mm
