polymech-info/heidenhain-simulator/fusion-ref/components/lucy/0.75 KW 60_1 AC motor v1/geometry/0.75 KW 60_1 AC motor v1.step

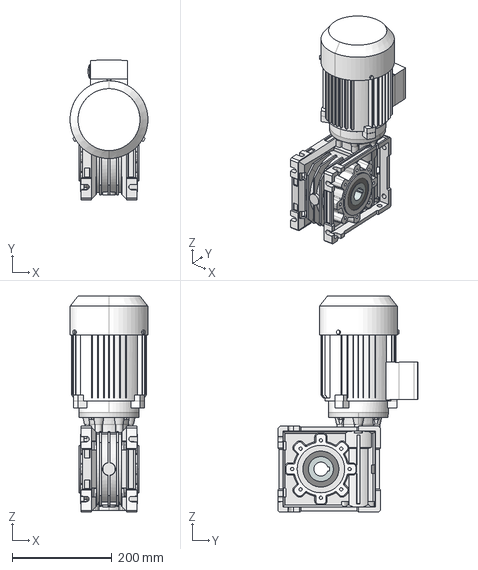
[picture p45: CAD file, 2026-09-25]
fusion-ref/components/lucy/0.75 KW 60_1 AC motor v1/geometry/0.75 KW 60_1 AC motor v1.step
156.0 x 280.5 x 432.5 mm
