polymech-info/heidenhain-simulator/fusion-ref/components/lucy/160 center  plus center hole v1/geometry/160 center  plus center hole v1.step

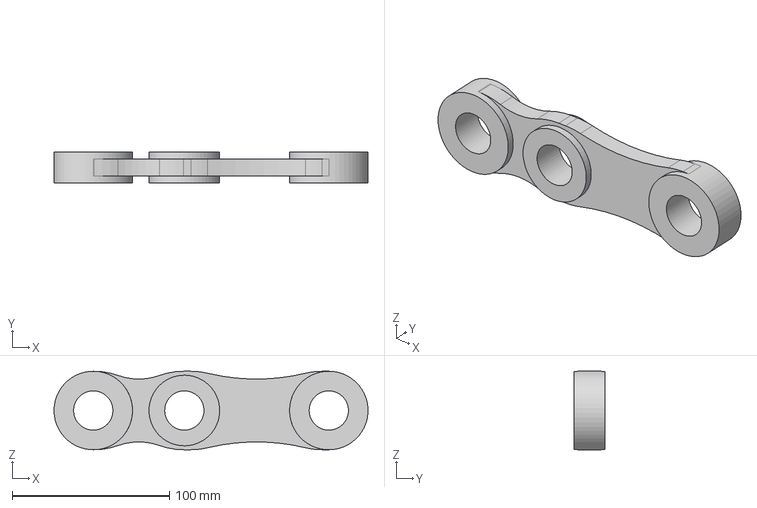
[picture p46: CAD file, 2026-09-25]
fusion-ref/components/lucy/160 center plus center hole v1/geometry/160 center plus center hole v1.step
200.0 x 20.0 x 50.0 mm
