polymech-info/heidenhain-simulator/fusion-ref/components/lucy/160 center link v1/geometry/160 center link v1.step

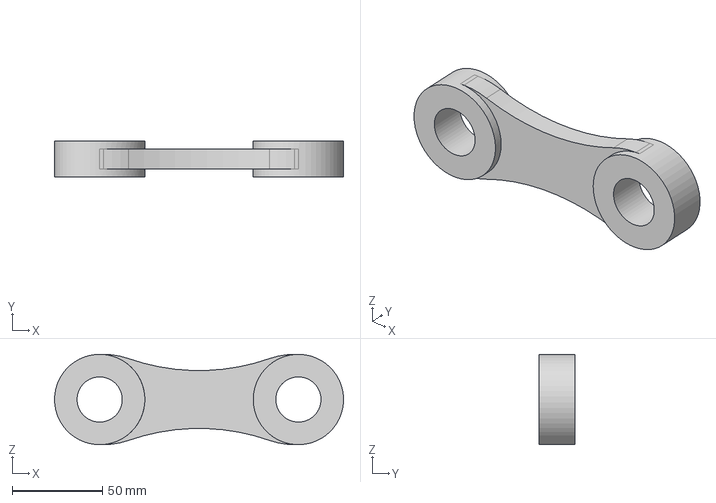
[picture p47: CAD file, 2026-09-25]
fusion-ref/components/lucy/160 center link v1/geometry/160 center link v1.step
160.0 x 20.0 x 50.0 mm
