polymech-info/heidenhain-simulator/fusion-ref/components/lucy/5 point toggle assamble v1/geometry/5 point toggle assamble v1.step

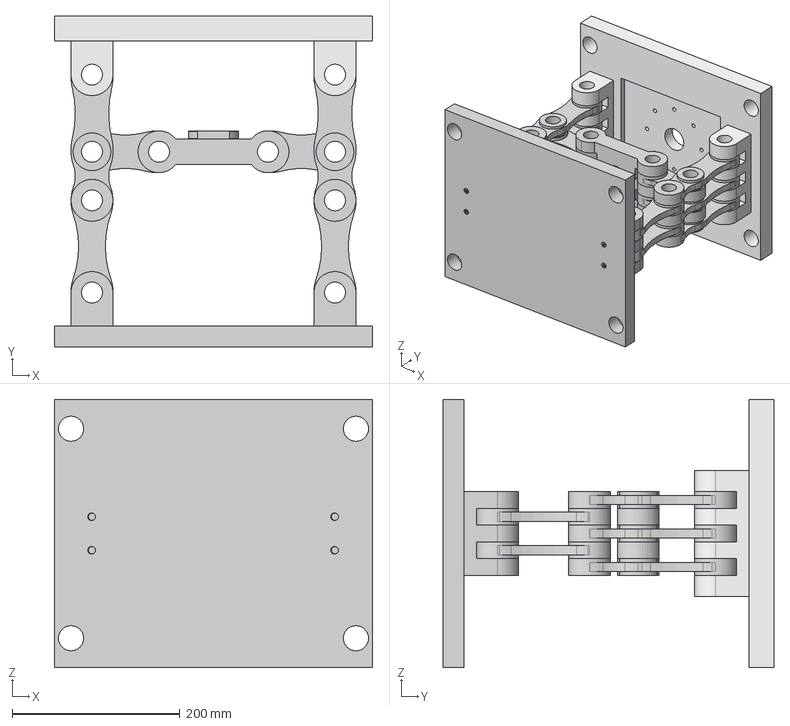
[picture p48: CAD file, 2026-09-25]
fusion-ref/components/lucy/5 point toggle assamble v1/geometry/5 point toggle assamble v1.step
380.0 x 395.0 x 320.0 mm
160 center plus center hole x 6
160 center link x 4
80 center link to draw bar x 4
draw rod thng
mount to mold x 2
6624K43_Flange Ball Nut
plate to mount moter on
mount to motor plate x 2
moving jaw
