polymech-info/heidenhain-simulator/fusion-ref/components/lucy/A side sample mold v1/geometry/A side sample mold v1.step

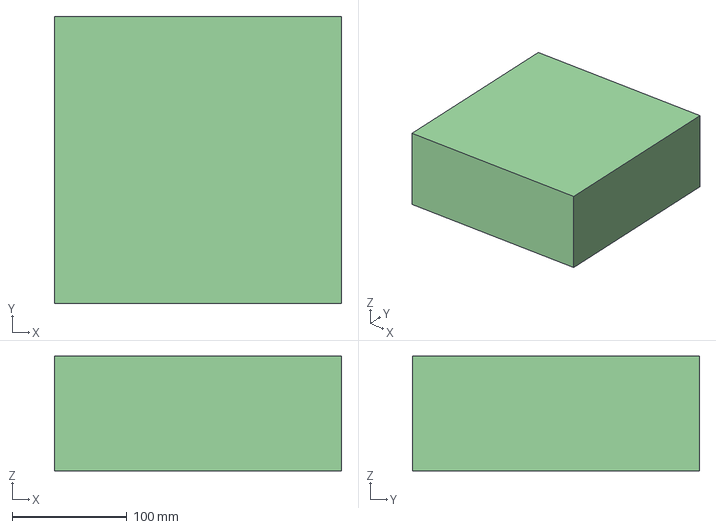
[picture p50: CAD file, 2026-09-25]
fusion-ref/components/lucy/A side sample mold v1/geometry/A side sample mold v1.step
250.0 x 250.0 x 100.0 mm
