polymech-info/heidenhain-simulator/fusion-ref/components/lucy/baseplate v1/geometry/baseplate v1.step

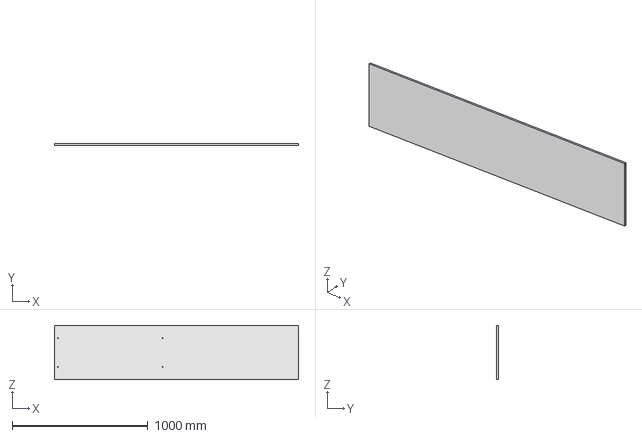
[picture p51: CAD file, 2026-09-25]
fusion-ref/components/lucy/baseplate v1/geometry/baseplate v1.step
1800.0 x 12.0 x 400.0 mm
