polymech-info/heidenhain-simulator/fusion-ref/components/lucy/conecter to motor v1/geometry/conecter to motor v1.step

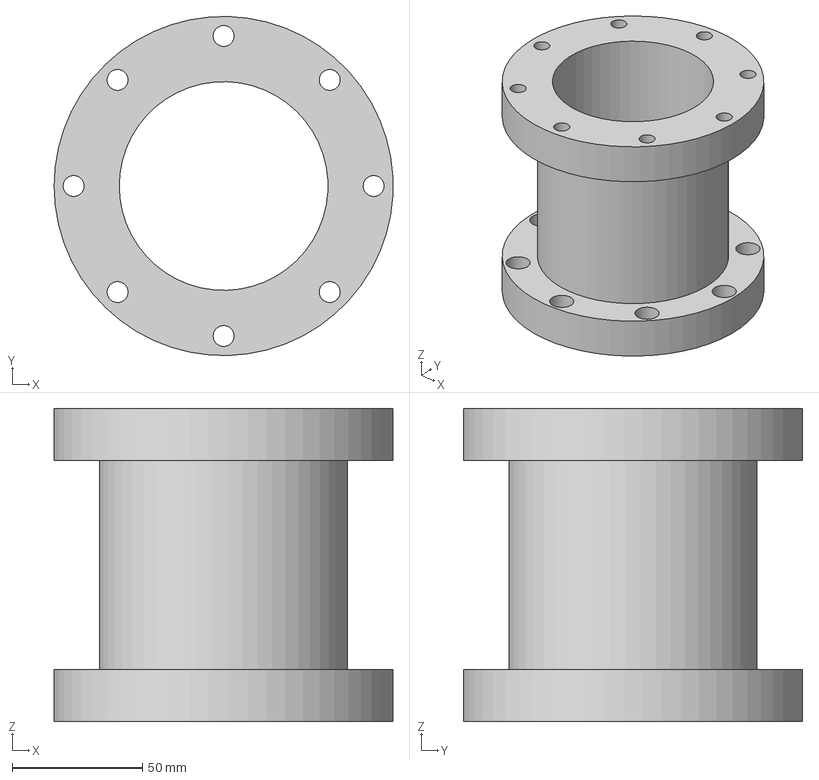
[picture p52: CAD file, 2026-09-25]
fusion-ref/components/lucy/conecter to motor v1/geometry/conecter to motor v1.step
129.9 x 129.9 x 120.0 mm
