polymech-info/heidenhain-simulator/fusion-ref/components/lucy/coupling assambly v1/geometry/coupling assambly v1.step

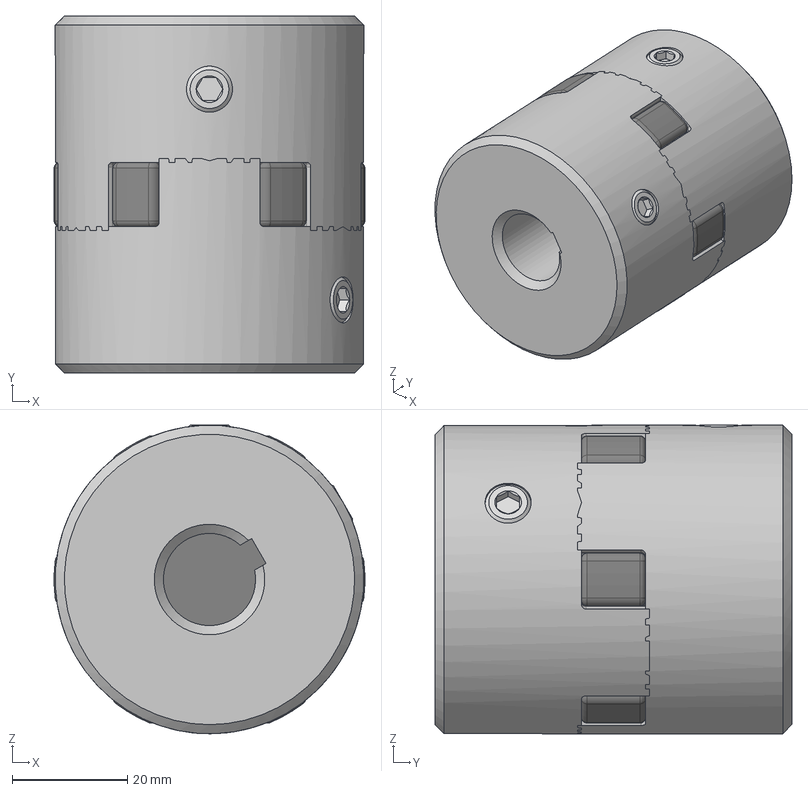
[picture p53: CAD file, 2026-09-25]
fusion-ref/components/lucy/coupling assambly v1/geometry/coupling assambly v1.step
53.9 x 62.0 x 53.6 mm
6408K75
6133N129_Set Screw Flexible Shaft Coupling
6133N129_Set Screw Flexible Shaft Coupling_1
