polymech-info/heidenhain-simulator/fusion-ref/components/lucy/couppler ro motor v1/geometry/couppler ro motor v1.step

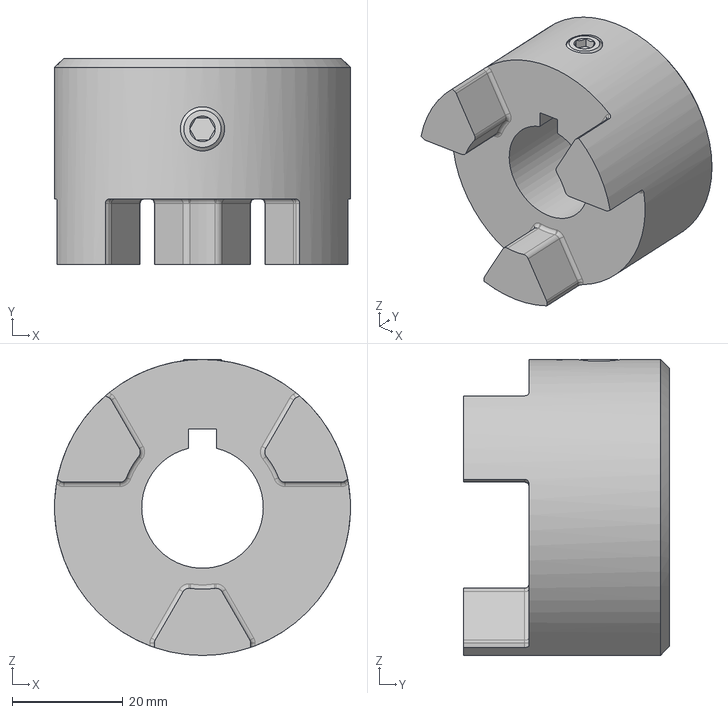
[picture p54: CAD file, 2026-09-25]
fusion-ref/components/lucy/couppler ro motor v1/geometry/couppler ro motor v1.step
53.6 x 37.2 x 53.6 mm
