polymech-info/heidenhain-simulator/fusion-ref/components/lucy/draw rod thng v1/geometry/draw rod thng v1.step

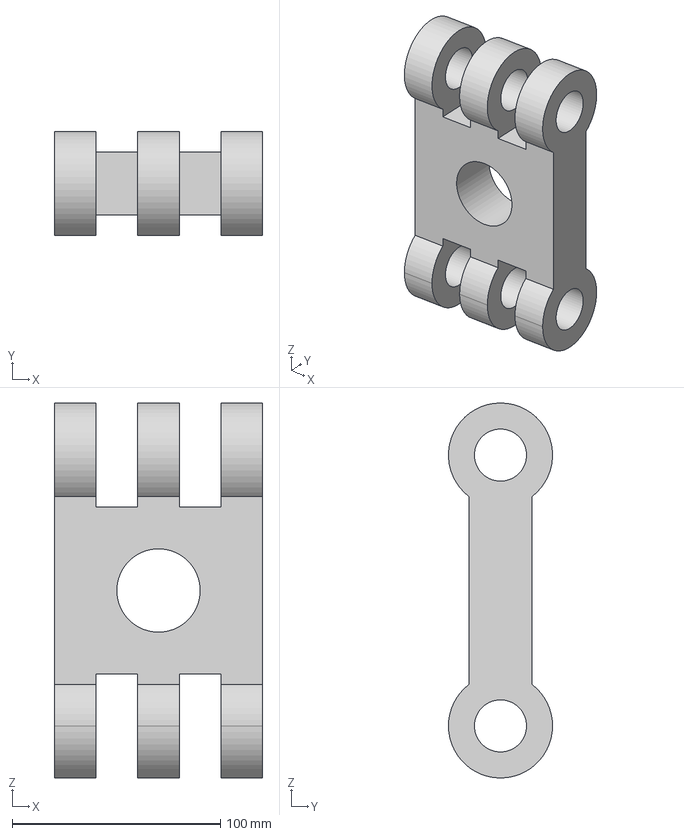
[picture p55: CAD file, 2026-09-25]
fusion-ref/components/lucy/draw rod thng v1/geometry/draw rod thng v1.step
100.0 x 50.0 x 180.0 mm
