polymech-info/heidenhain-simulator/fusion-ref/components/lucy/feet v1/geometry/feet v1.step

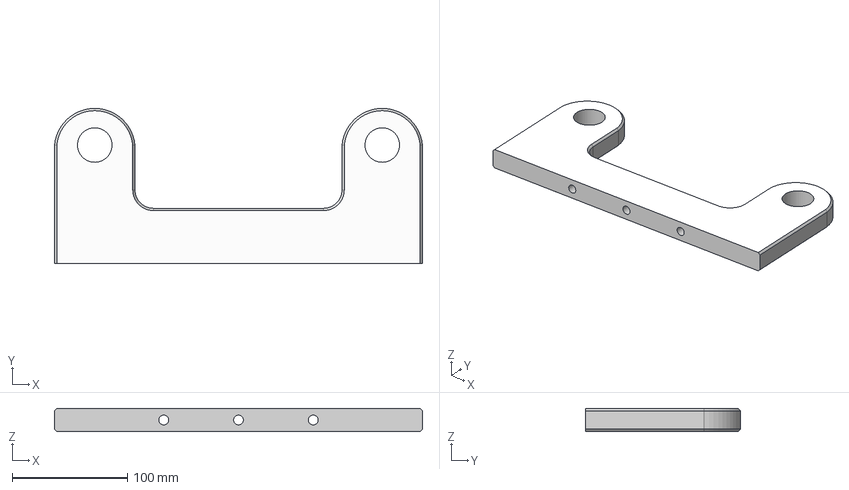
[picture p56: CAD file, 2026-09-25]
fusion-ref/components/lucy/feet v1/geometry/feet v1.step
320.0 x 135.0 x 20.0 mm
