polymech-info/heidenhain-simulator/fusion-ref/components/lucy/fixed jaw v1/geometry/fixed jaw v1.step

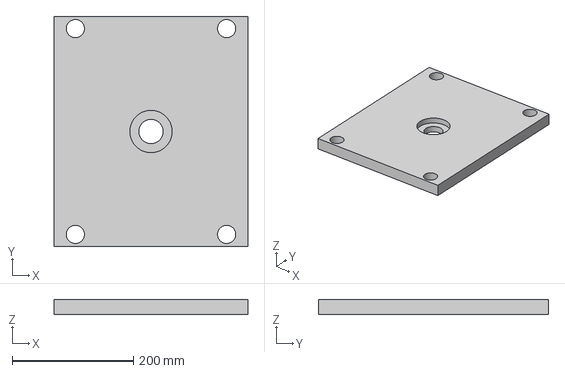
[picture p57: CAD file, 2026-09-25]
fusion-ref/components/lucy/fixed jaw v1/geometry/fixed jaw v1.step
320.0 x 380.0 x 25.0 mm
