polymech-info/heidenhain-simulator/fusion-ref/components/lucy/mount to mold v1/geometry/mount to mold v1.step

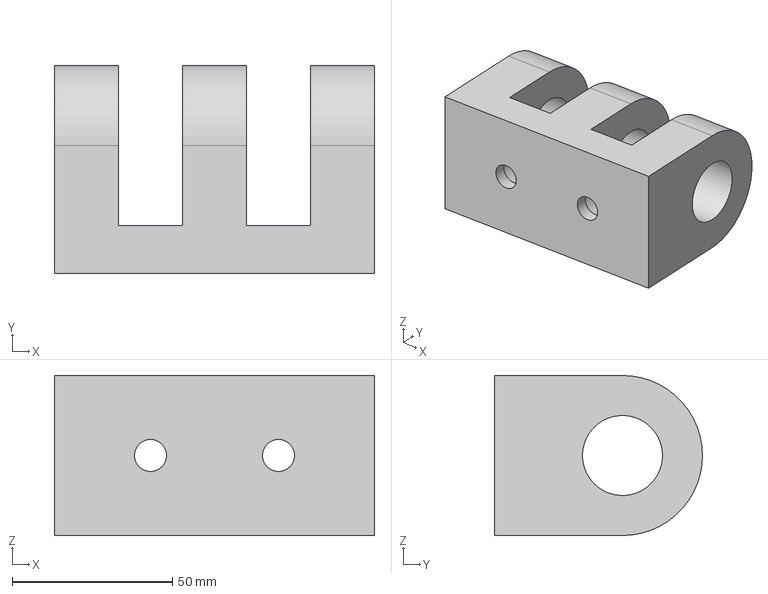
[picture p58: CAD file, 2026-09-25]
fusion-ref/components/lucy/mount to mold v1/geometry/mount to mold v1.step
100.0 x 65.0 x 50.0 mm
