polymech-info/heidenhain-simulator/fusion-ref/components/lucy/mount to motor plate v1/geometry/mount to motor plate v1.step

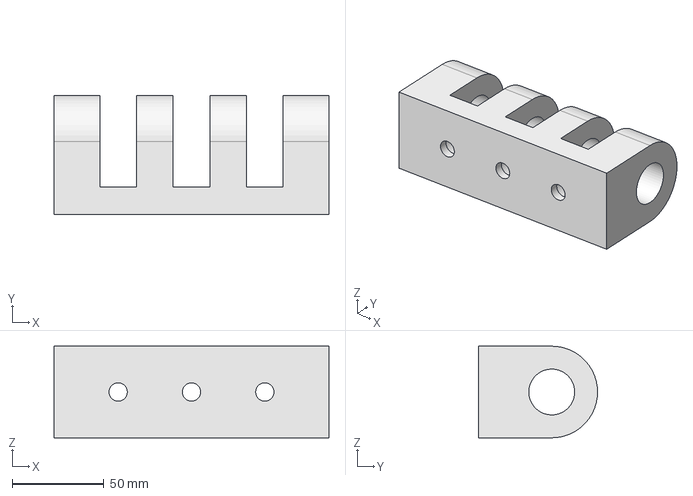
[picture p59: CAD file, 2026-09-25]
fusion-ref/components/lucy/mount to motor plate v1/geometry/mount to motor plate v1.step
150.0 x 65.0 x 50.0 mm
