polymech-info/heidenhain-simulator/fusion-ref/components/lucy/moving jaw v1/geometry/moving jaw v1.step

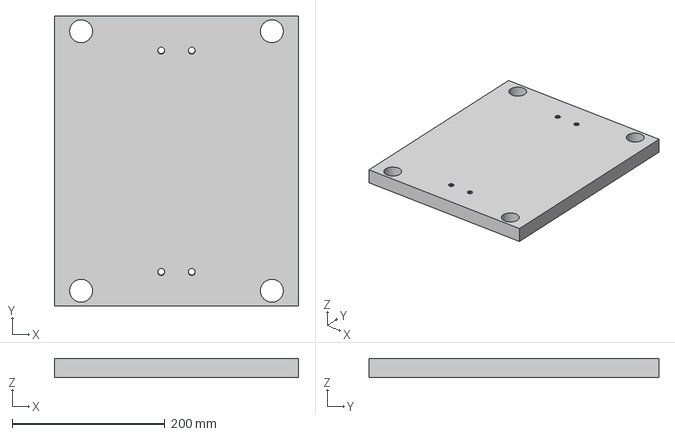
[picture p60: CAD file, 2026-09-25]
fusion-ref/components/lucy/moving jaw v1/geometry/moving jaw v1.step
320.0 x 380.0 x 25.0 mm
