polymech-info/heidenhain-simulator/fusion-ref/components/lucy/plate assambly v1/geometry/plate assambly v1.step

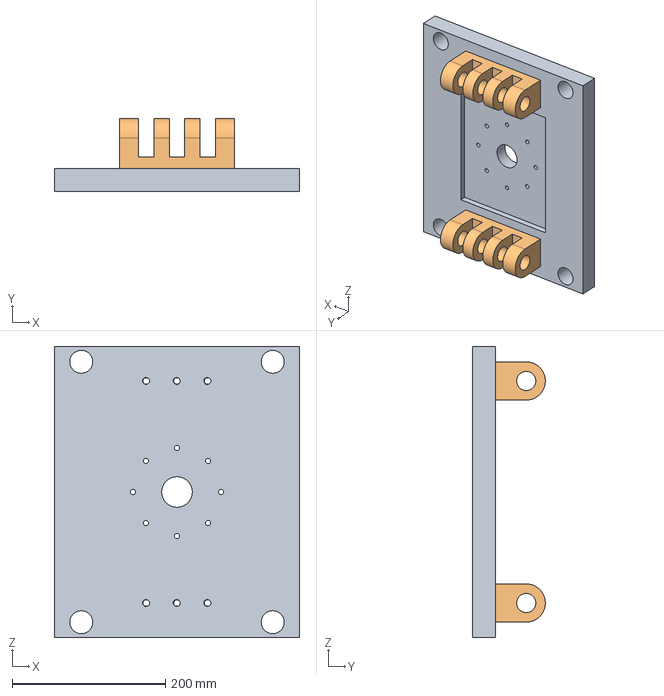
[picture p61: CAD file, 2026-09-25]
fusion-ref/components/lucy/plate assambly v1/geometry/plate assambly v1.step
320.0 x 95.0 x 380.0 mm
plate to mount moter on
mount to motor plate x 2
