polymech-info/heidenhain-simulator/fusion-ref/components/lucy/plate to mount moter on v1/geometry/plate to mount moter on v1.step

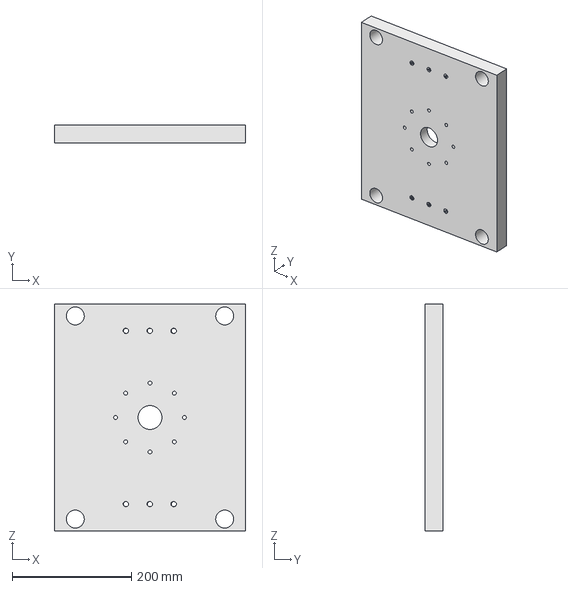
[picture p62: CAD file, 2026-09-25]
fusion-ref/components/lucy/plate to mount moter on v1/geometry/plate to mount moter on v1.step
320.0 x 30.0 x 380.0 mm
