polymech-info/heidenhain-simulator/fusion-ref/components/lucy/rubber thingy inbetween v1/geometry/rubber thingy inbetween v1.step

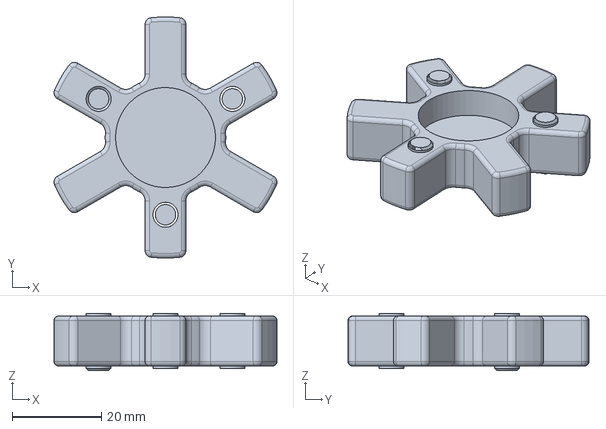
[picture p63: CAD file, 2026-09-25]
fusion-ref/components/lucy/rubber thingy inbetween v1/geometry/rubber thingy inbetween v1.step
49.9 x 53.9 x 13.2 mm
