polymech-info/heidenhain-simulator/fusion-ref/components/lucy/shat from morot to coupler v1/geometry/shat from morot to coupler v1.step

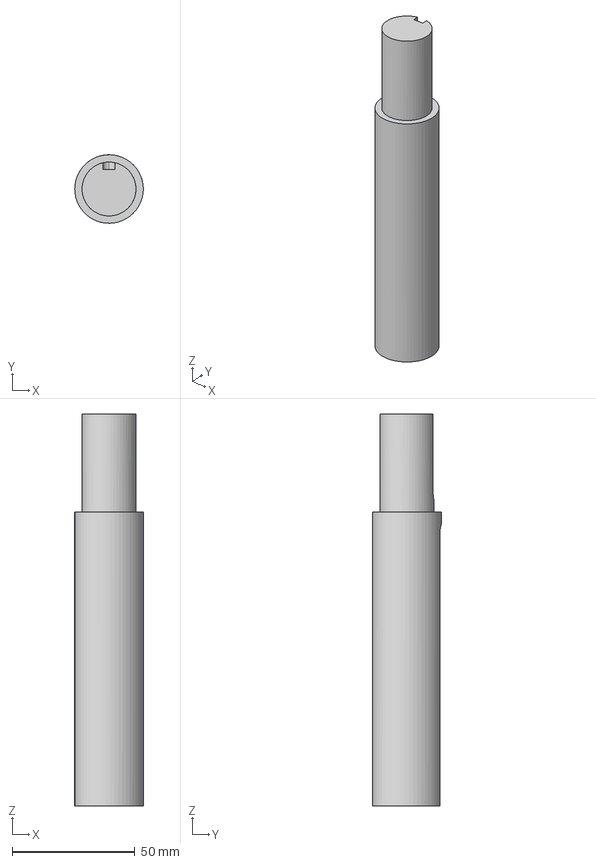
[picture p64: CAD file, 2026-09-25]
fusion-ref/components/lucy/shat from morot to coupler v1/geometry/shat from morot to coupler v1.step
28.0 x 28.0 x 160.0 mm
