polymech-info/heidenhain-simulator/fusion-ref/components/lucy/tie rods v1/geometry/tie rods v1.step

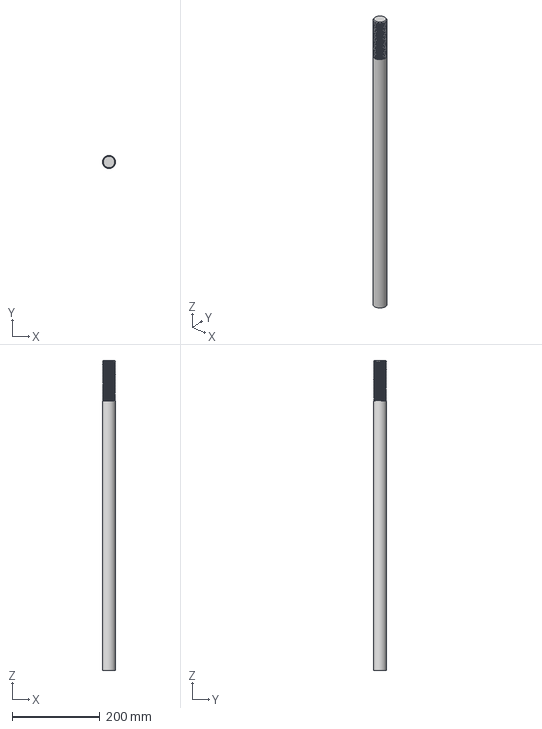
[picture p65: CAD file, 2026-09-25]
fusion-ref/components/lucy/tie rods v1/geometry/tie rods v1.step
29.7 x 29.7 x 705.0 mm
