polymech-info/heidenhain-simulator/fusion-ref/components/lydia-3.5/Barrel - Printhead v1/geometry/Barrel - Printhead v1.step

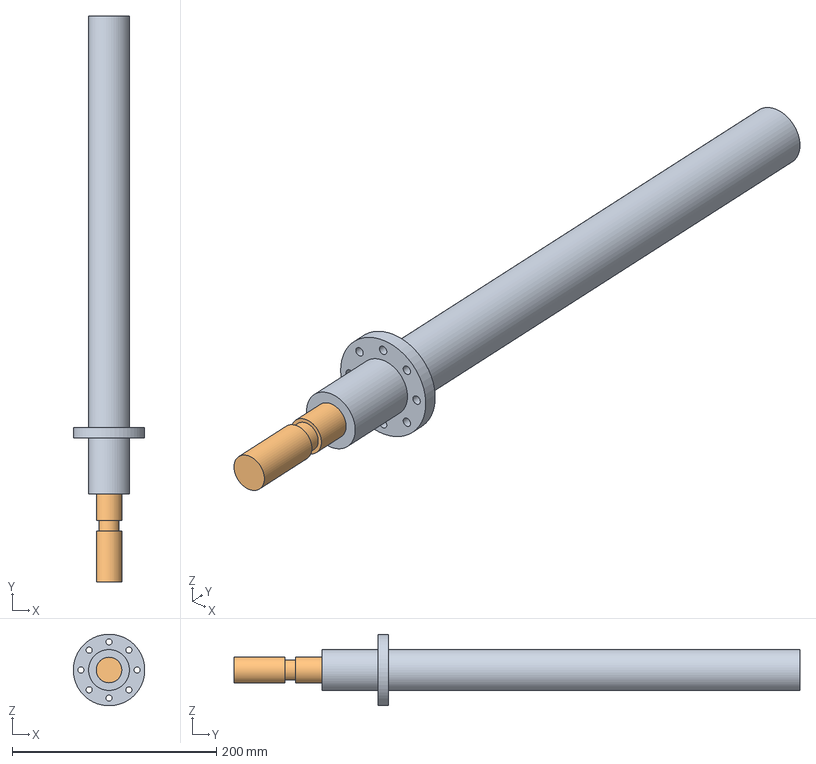
[picture p68: CAD file, 2026-09-25]
fusion-ref/components/lydia-3.5/Barrel - Printhead v1/geometry/Barrel - Printhead v1.step
69.9 x 554.0 x 70.0 mm
