polymech-info/heidenhain-simulator/fusion-ref/components/misc/hy-vfd v2/geometry/hy-vfd v2.step

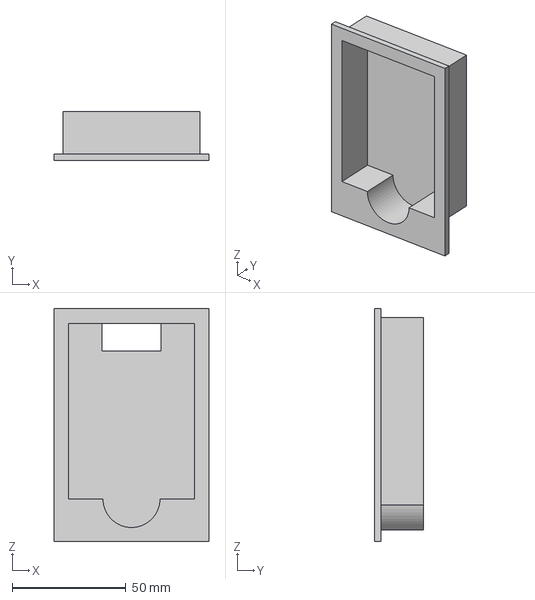
[picture p69: CAD file, 2026-09-25]
fusion-ref/components/misc/hy-vfd v2/geometry/hy-vfd v2.step
68.0 x 21.7 x 102.3 mm
