polymech-info/heidenhain-simulator/fusion-ref/components/misc/Optoacoplador LM393 v1/geometry/Optoacoplador LM393 v1.step

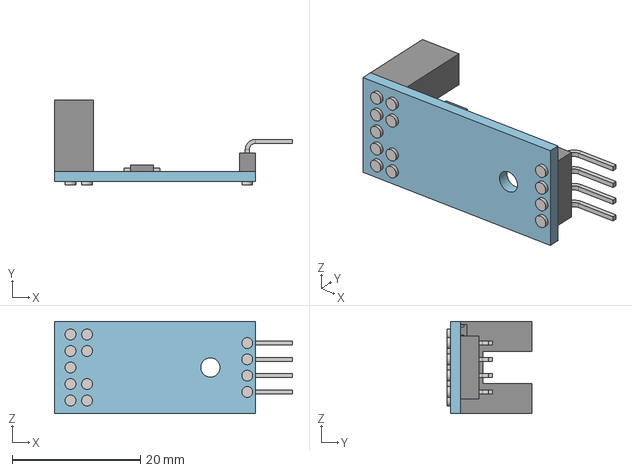
[picture p70: CAD file, 2026-09-25]
fusion-ref/components/misc/Optoacoplador LM393 v1/geometry/Optoacoplador LM393 v1.step
37.1 x 13.2 x 14.4 mm
