polymech-info/heidenhain-simulator/fusion-ref/components/obelix/15_BEARING-HOUSING_x4_12mm_INOX v1/geometry/15_BEARING-HOUSING_x4_12mm_INOX v1.step

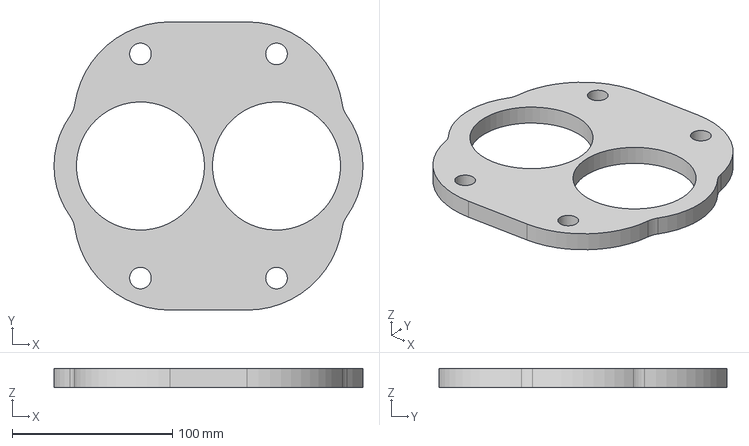
[picture p71: CAD file, 2026-09-25]
fusion-ref/components/obelix/15_BEARING-HOUSING_x4_12mm_INOX v1/geometry/15_BEARING-HOUSING_x4_12mm_INOX v1.step
193.0 x 180.0 x 12.0 mm
