polymech-info/heidenhain-simulator/fusion-ref/components/pellet-cutter/cone v1/geometry/cone v1.step

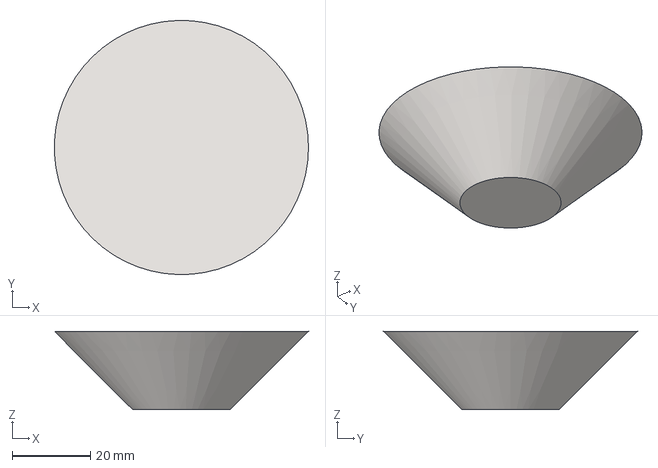
[picture p72: CAD file, 2026-09-25]
fusion-ref/components/pellet-cutter/cone v1/geometry/cone v1.step
65.0 x 65.0 x 20.0 mm
