polymech-info/heidenhain-simulator/fusion-ref/components/pellet-cutter/die_insert_plate v1/geometry/die_insert_plate v1.step

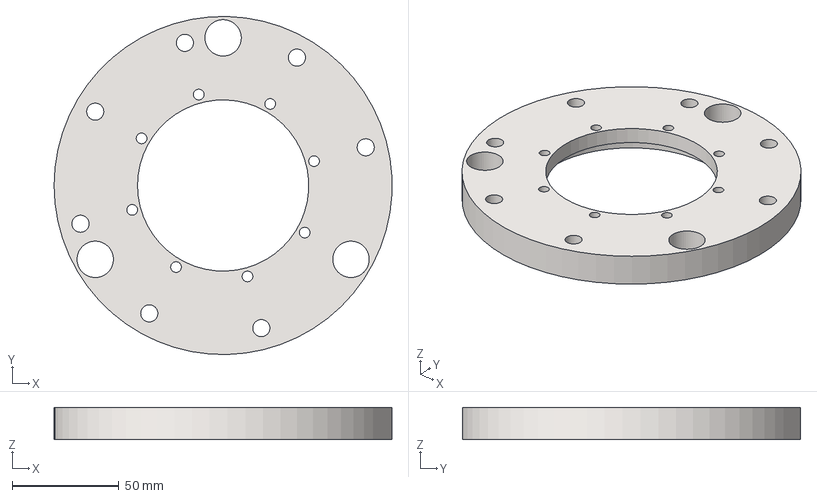
[picture p73: CAD file, 2026-09-25]
fusion-ref/components/pellet-cutter/die_insert_plate v1/geometry/die_insert_plate v1.step
157.9 x 157.9 x 15.0 mm
