polymech-info/heidenhain-simulator/fusion-ref/components/pellet-cutter/Heat_band v1/geometry/Heat_band v1.step

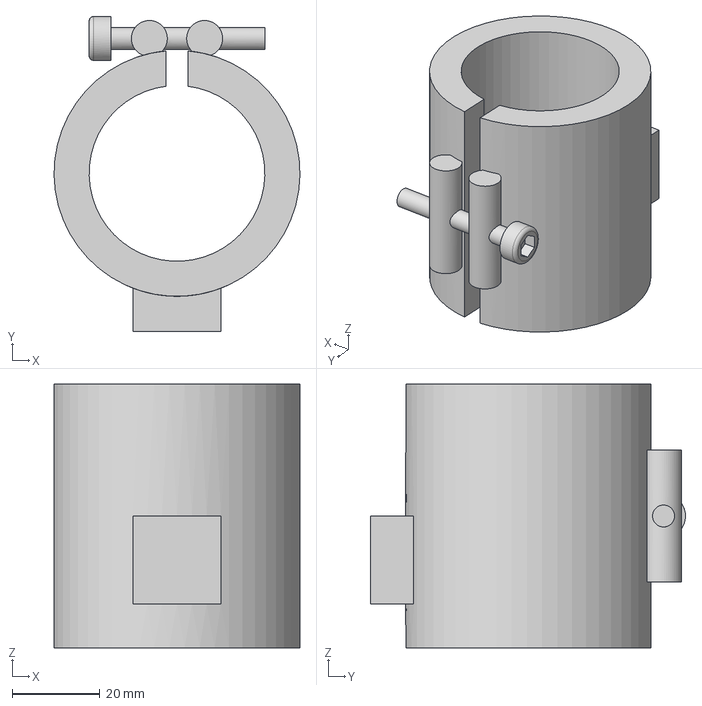
[picture p74: CAD file, 2026-09-25]
fusion-ref/components/pellet-cutter/Heat_band v1/geometry/Heat_band v1.step
56.0 x 71.7 x 60.0 mm
