polymech-info/heidenhain-simulator/fusion-ref/components/pellet-cutter/init v9/geometry/init v9.step

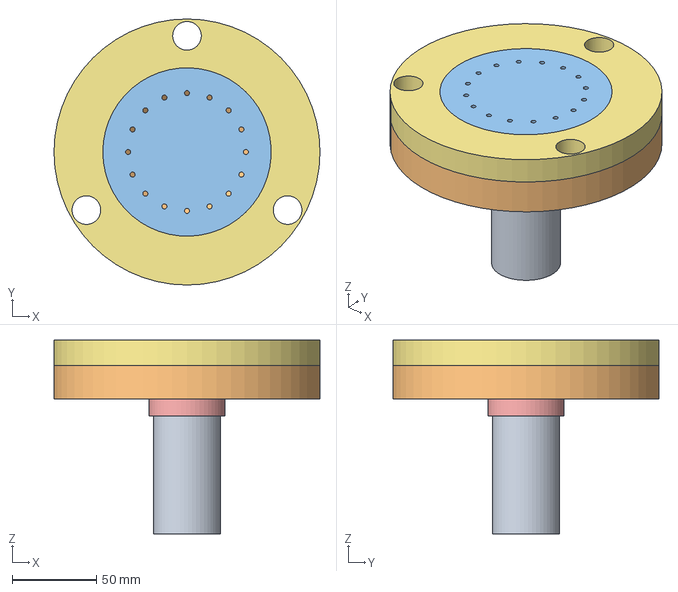
[picture p75: CAD file, 2026-09-25]
fusion-ref/components/pellet-cutter/init v9/geometry/init v9.step
158.0 x 158.0 x 115.0 mm
