polymech-info/heidenhain-simulator/fusion-ref/components/pellet-cutter/v8 v1/geometry/v8 v1.step

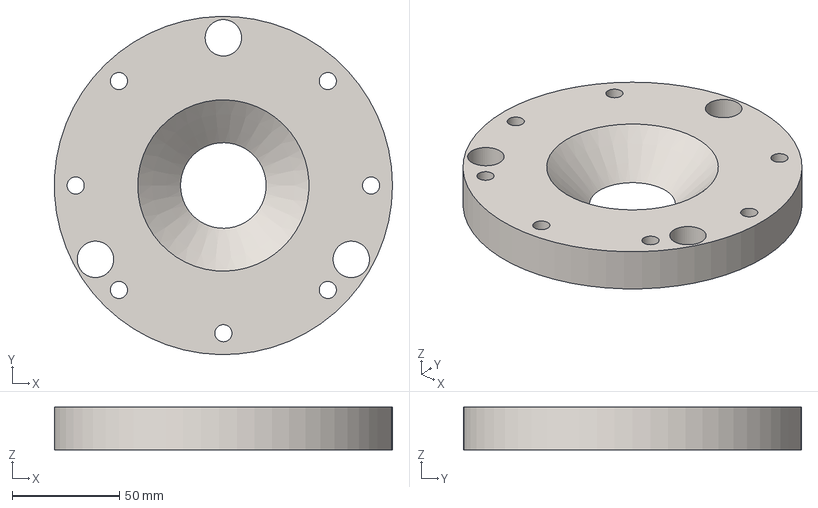
[picture p76: CAD file, 2026-09-25]
fusion-ref/components/pellet-cutter/v8 v1/geometry/v8 v1.step
157.9 x 157.9 x 20.0 mm
