polymech-info/heidenhain-simulator/fusion-ref/components/steppers/nema23/Coupling-Housing-500-80 v2/geometry/Coupling-Housing-500-80 v2.step

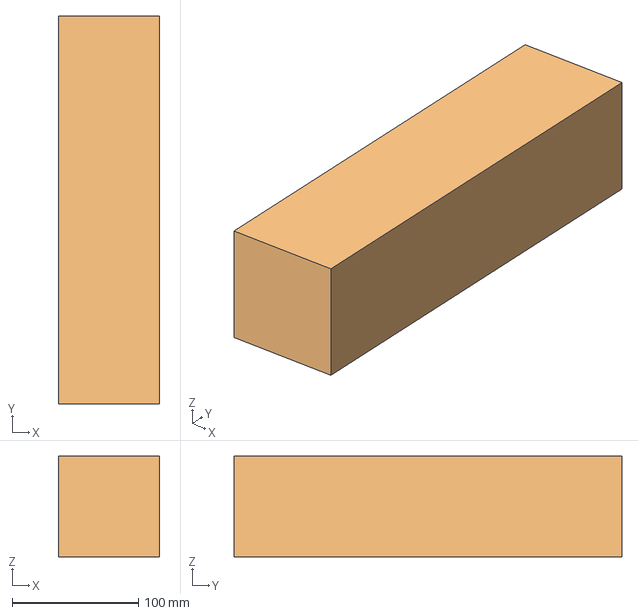
[picture p77: CAD file, 2026-09-25]
fusion-ref/components/steppers/nema23/Coupling-Housing-500-80 v2/geometry/Coupling-Housing-500-80 v2.step
80.0 x 307.7 x 80.0 mm
CouplingHousing-60w-40l-N23 x 4
Stock^Nema-23-PX57-Coupling
