polymech-info/heidenhain-simulator/fusion-ref/components/stock/BarrelFlange-100-55-40 v1/geometry/BarrelFlange-100-55-40 v1.step

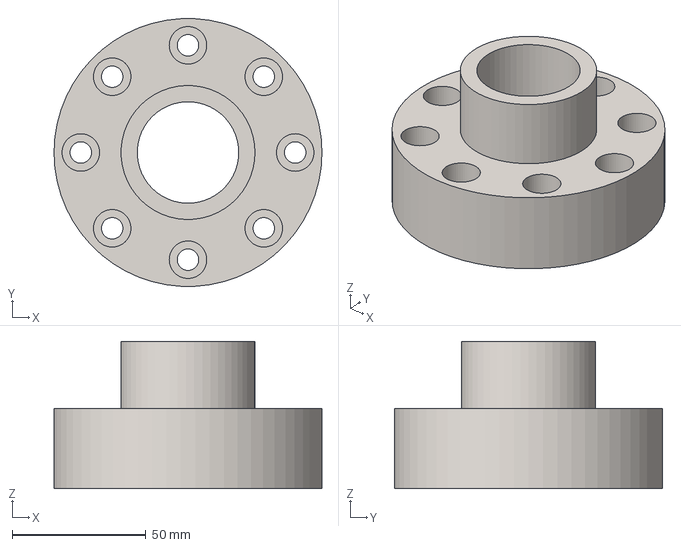
[picture p78: CAD file, 2026-09-25]
fusion-ref/components/stock/BarrelFlange-100-55-40 v1/geometry/BarrelFlange-100-55-40 v1.step
100.0 x 99.9 x 55.0 mm
