polymech-info/heidenhain-simulator/fusion-ref/components/table v1/geometry/table v1.step

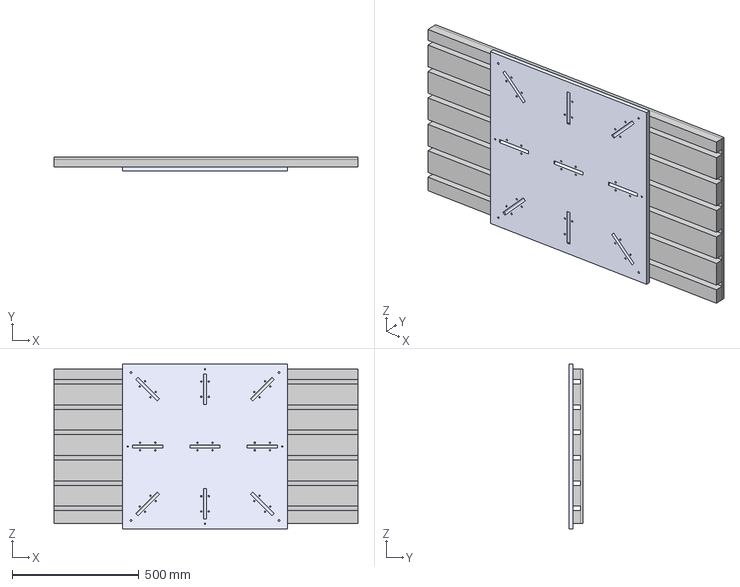
[picture p79: CAD file, 2026-09-25]
fusion-ref/components/table v1/geometry/table v1.step
1200.0 x 55.0 x 650.0 mm
Table_1
sp-artition-cell v1
