polymech-info/heidenhain-simulator/fusion-ref/components/textile-feeder/511_HopperMount-Lower-85-120-80 v1/geometry/511_HopperMount-Lower-85-120-80 v1.step

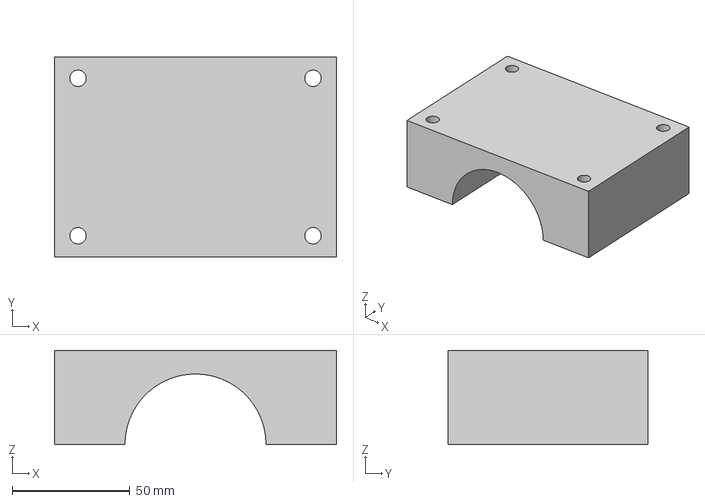
[picture p81: CAD file, 2026-09-25]
fusion-ref/components/textile-feeder/511_HopperMount-Lower-85-120-80 v1/geometry/511_HopperMount-Lower-85-120-80 v1.step
120.0 x 85.0 x 40.0 mm
