polymech-info/heidenhain-simulator/fusion-ref/components/textile-feeder/511_HopperMount-Reserve v1/geometry/511_HopperMount-Reserve v1.step

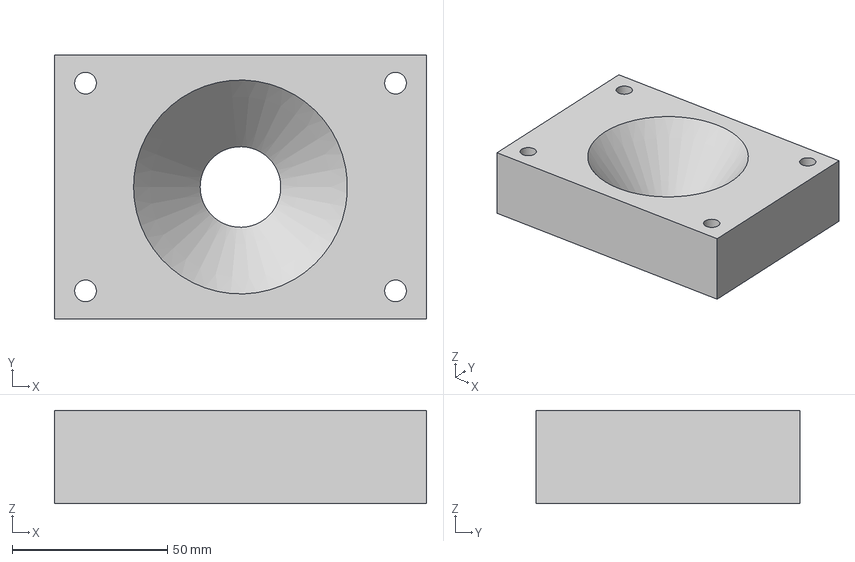
[picture p82: CAD file, 2026-09-25]
fusion-ref/components/textile-feeder/511_HopperMount-Reserve v1/geometry/511_HopperMount-Reserve v1.step
120.0 x 85.0 x 30.0 mm
