polymech-info/heidenhain-simulator/fusion-ref/components/vintage-edc/403_MountPlate_x2_4mm_INOX v1/geometry/403_MountPlate_x2_4mm_INOX v1.step

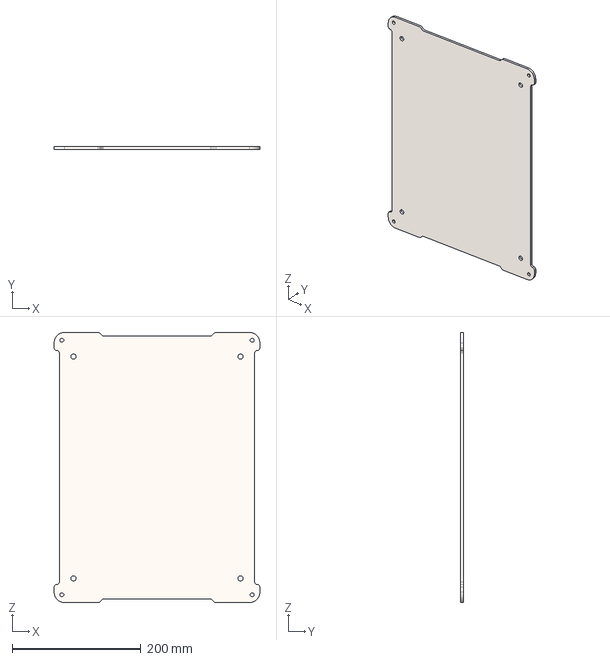
[picture p83: CAD file, 2026-09-25]
fusion-ref/components/vintage-edc/403_MountPlate_x2_4mm_INOX v1/geometry/403_MountPlate_x2_4mm_INOX v1.step
320.0 x 4.00 x 420.0 mm
