polymech-info/heidenhain-simulator/fusion-ref/components/vintage-edc/CAM-Cabinet-EDC-Flex-Drive-130 v1/geometry/CAM-Cabinet-EDC-Flex-Drive-130 v1.step

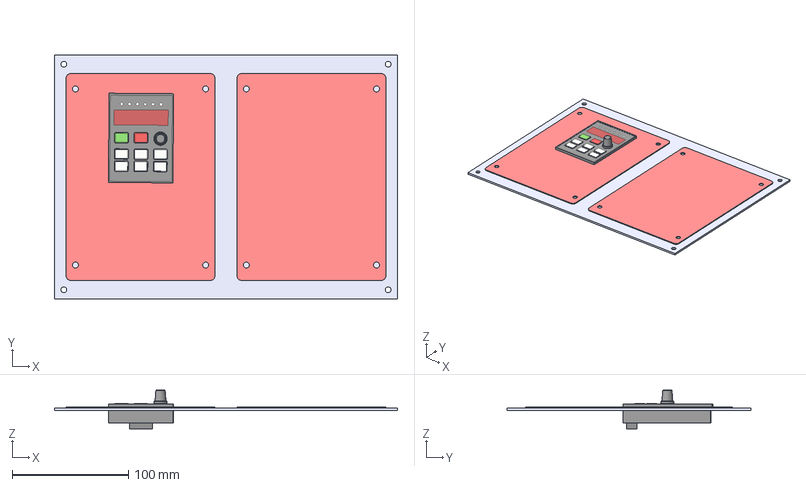
[picture p84: CAD file, 2026-09-25]
fusion-ref/components/vintage-edc/CAM-Cabinet-EDC-Flex-Drive-130 v1/geometry/CAM-Cabinet-EDC-Flex-Drive-130 v1.step
295.0 x 210.0 x 33.3 mm
Panels-Sheet-Stock-A4
811_BackPanel_x2_1mm_INOX x 2
vfd-cp
