polymech-info/heidenhain-simulator/fusion-ref/components/vintage-edc/CAM-TopPanel v1/geometry/CAM-TopPanel v1.step

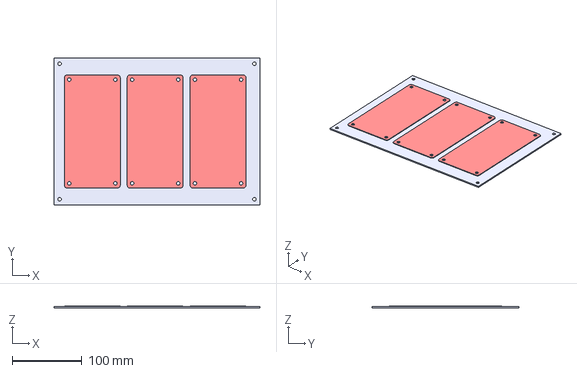
[picture p85: CAD file, 2026-09-25]
fusion-ref/components/vintage-edc/CAM-TopPanel v1/geometry/CAM-TopPanel v1.step
295.0 x 210.0 x 3.00 mm
612_SidePanel_x2_1mm_INOX x 3
Panels-Sheet-Stock-A4
