polymech-info/heidenhain-simulator/fusion-ref/flexi-print/1000-plate v1/geometry/1000-plate v1.step

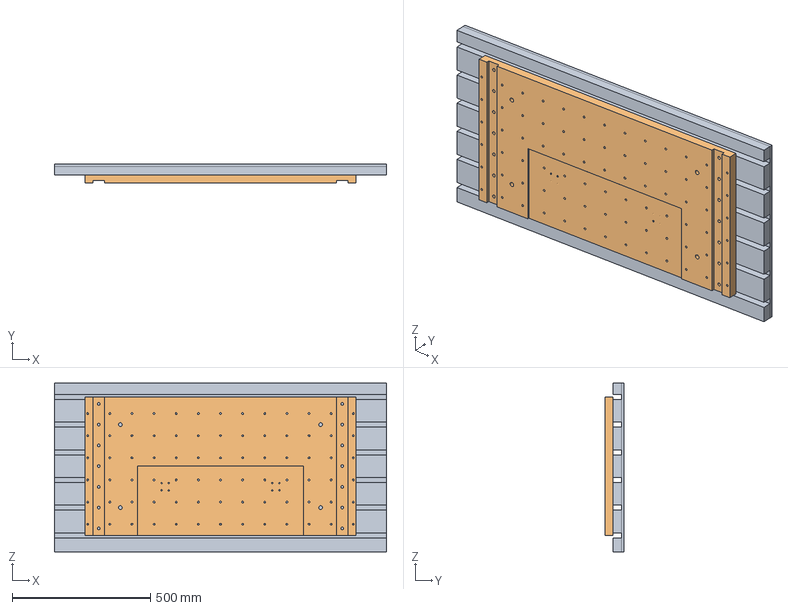
[picture p86: CAD file, 2026-09-25]
fusion-ref/flexi-print/1000-plate v1/geometry/1000-plate v1.step
1200.0 x 70.0 x 610.0 mm
table-1200-600
Rail-MountPlate-Y
