polymech-info/heidenhain-simulator/cli/cad/tests/cas/cad/press-frame-2/Lower Platen Matrix Assembly Light2.SLDASM

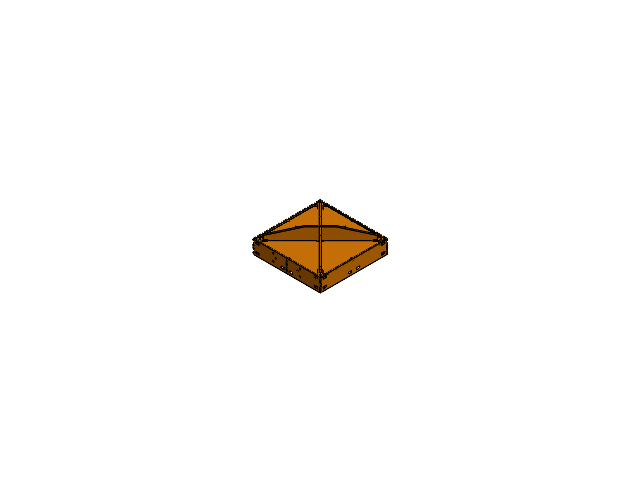
[picture p87: CAD file, 2026-09-25]
cli/cad/tests/cas/cad/press-frame-2/Lower Platen Matrix Assembly Light2.SLDASM
8_Rib_x2_5mm_FERRO.DXF
7_Rib_x2_5mm_FERRO.DXF
7_Side_x2_5mm_FERRO.DXF x 2
6_Side_x4_5mm_FERRO.DXF x 2
303_TriMount_x18_10mm_FERRO x 9
202_PlateCover_x2_1mm_INOX2
200_RIBA1_x2_10mm_FERRO
200_RIBA1B_x2_10mm_FERRO
302_RibMount_x8_5mm_FERRO x 4
