polymech-info/heidenhain-simulator/(list of files, cad)

Other CAD files:
cli/cad/tests/html/barrel.SLDASM
fusion-ref/components/BarrelAssembly-RD-25d-40-v3.8.2 v2/geometry/BarrelAssembly-RD-25d-40-v3.8.2 v2.step
fusion-ref/moulds/container/quadro-main v17/geometry/quadro-main v17.step
cli/cad/tests/cabinet/packed/2P-Power.SLDASM
cli/cad/tests/cabinet/2P-Power.SLDASM
cli/cad/tests/cabinet/packed/CAM-FrontPanel.SLDASM
cli/cad/tests/cabinet/EDC-Render.SLDASM
cli/cad/tests/cabinet/Cabinet-EDC-Flex.SLDASM
fusion-ref/components/200-cab-ezm v1/geometry/200-cab-ezm v1.step
fusion-ref/components/auto-plunger/Plunger-Mount v6/geometry/Plunger-Mount v6.step
fusion-ref/components/barrel-opening v2/geometry/barrel-opening v2.step
fusion-ref/components/Couplings - Shredder v18/geometry/Couplings - Shredder v18.step
fusion-ref/components/filament-cooler/701_Front_x1_2mm_INOX v5/geometry/701_Front_x1_2mm_INOX v5.step
fusion-ref/components/flange v4/geometry/flange v4.step
fusion-ref/components/Flange-160-90 v5/geometry/Flange-160-90 v5.step
fusion-ref/components/Flange-160-90-120x50 v1/geometry/Flange-160-90-120x50 v1.step
fusion-ref/components/gears/mod-25-22T v3/geometry/mod-25-22T v3.step
fusion-ref/components/HAL9000 ControlPanel Front v5/geometry/HAL9000 ControlPanel Front v5.step
fusion-ref/components/hopper-mount/510_HopperMount-40 v8/geometry/510_HopperMount-40 v8.step
fusion-ref/components/hopper-mount/510_HopperMount-40-110-30-85 v7/geometry/510_HopperMount-40-110-30-85 v7.step
fusion-ref/components/hopper-mount/510_HopperMount-40-110-86-25h v4/geometry/510_HopperMount-40-110-86-25h v4.step
fusion-ref/components/hopper-mount/510_HopperMount-40-120 v2/geometry/510_HopperMount-40-120 v2.step
fusion-ref/components/hopper-mount/510_HopperMount-40-120-30-85 v4/geometry/510_HopperMount-40-120-30-85 v4.step
fusion-ref/components/hopper-mount/510_HopperMount-40-120-30-85-master v3/geometry/510_HopperMount-40-120-30-85-master v3.step
fusion-ref/components/hopper-mount/510_HopperMount-40-120-30-85-v2 v1/geometry/510_HopperMount-40-120-30-85-v2 v1.step
fusion-ref/components/hopper-mount/510_HopperMount-85-120-RC2 v2/geometry/510_HopperMount-85-120-RC2 v2.step
fusion-ref/components/hopper-mount/510_HopperMount-Feed-40-120-30-85-v2 v6/geometry/510_HopperMount-Feed-40-120-30-85-v2 v6.step
fusion-ref/components/injection/injection-hub v4/geometry/injection-hub v4.step
fusion-ref/components/injection/sticks v3/geometry/sticks v3.step
fusion-ref/components/lucy/B side sample mold v1/geometry/B side sample mold v1.step
fusion-ref/components/lydia-3.5/bearing-housing-dims v2/geometry/bearing-housing-dims v2.step
fusion-ref/components/lydia-3.5/mesh v1/geometry/mesh v1.step
fusion-ref/components/lydia/l4-cooling v3/geometry/l4-cooling v3.step
fusion-ref/components/Mini-Extruder-CP v3/geometry/Mini-Extruder-CP v3.step
fusion-ref/components/misc/1605 v2/geometry/1605 v2.step
fusion-ref/components/misc/LoveJoy+Coupler v1/geometry/LoveJoy+Coupler v1.step
fusion-ref/components/misc/Nema+23+Step+Motor v1/geometry/Nema+23+Step+Motor v1.step
fusion-ref/components/misc/NEMA+34+Mount v6/geometry/NEMA+34+Mount v6.step
fusion-ref/components/misc/Nema-23-Gantry-Bracket v5 v5/geometry/Nema-23-Gantry-Bracket v5 v5.step
fusion-ref/components/misc/sfu1605 v1/geometry/sfu1605 v1.step
fusion-ref/components/nozzles/M30-Injection v2/geometry/M30-Injection v2.step
fusion-ref/components/obelix/Obelix-Bearing v5/geometry/Obelix-Bearing v5.step
fusion-ref/components/pellet-cutter/die v66/geometry/die v66.step
fusion-ref/components/pellet-cutter/pellet - die - v6/geometry/pellet - die - v6.step
fusion-ref/components/Plunger-Mounts v5/geometry/Plunger-Mounts v5.step
fusion-ref/components/shpere v1/geometry/shpere v1.step
fusion-ref/components/shredder-light v2/geometry/shredder-light v2.step
fusion-ref/components/slots v19/geometry/slots v19.step
fusion-ref/components/steppers/nema23/Coupling-Housing-120-100-Nema23 v1/geometry/Coupling-Housing-120-100-Nema23 v1.step
fusion-ref/components/steppers/nema23/Coupling-Housing-120-100-Nema23-Single v5/geometry/Coupling-Housing-120-100-Nema23-Single v5.step
fusion-ref/components/steppers/nema23/Coupling-Housing-500-80-Nema23 v3/geometry/Coupling-Housing-500-80-Nema23 v3.step
fusion-ref/components/steppers/nema23/Nema-23-PX57-Coupling v1/geometry/Nema-23-PX57-Coupling v1.step
fusion-ref/components/stock/650x650x30_440 v5/geometry/650x650x30_440 v5.step
fusion-ref/components/textile-feeder/template v4/geometry/template v4.step
fusion-ref/components/valve/myr-v1-20d v1/geometry/myr-v1-20d v1.step
fusion-ref/components/valve/myr-v1-35 v4/geometry/myr-v1-35 v4.step
fusion-ref/components/vintage-edc/403_MountPlate_x2_4mm_INOX-rc-1 v1/geometry/403_MountPlate_x2_4mm_INOX-rc-1 v1.step
fusion-ref/components/vintage-edc/CAM-FrontPanel v1/geometry/CAM-FrontPanel v1.step
fusion-ref/components/vintage-edc/CAM-SidePanel v1/geometry/CAM-SidePanel v1.step
fusion-ref/components/vintage-edc/edc-rc1 v8/geometry/edc-rc1 v8.step
fusion-ref/components/zoe-leg v5/geometry/zoe-leg v5.step
fusion-ref/flexi-print/components/endstop-mounts v2/geometry/endstop-mounts v2.step
fusion-ref/flexi-print/components/fixtures v2/geometry/fixtures v2.step
cli/cad/tests/cabinet/403_MountPlate_x2_4mm_INOX.SLDPRT
cli/cad/tests/cabinet/520_BeltUX_x2_1mm_INOX.SLDPRT
cli/cad/tests/cabinet/520_Belt_x2_1mm_INOX.SLDPRT
cli/cad/tests/cabinet/525_Belt_x1_1mm_INOX.SLDPRT
cli/cad/tests/cabinet/530_BasePost.SLDPRT
cli/cad/tests/cabinet/540_KatBeltMini.SLDPRT
cli/cad/tests/cabinet/540_MiddlePlate_x2_1mm_INOX.SLDPRT
cli/cad/tests/cabinet/610_FrontPanel_x1_1mm_INOX.SLDPRT
cli/cad/tests/cabinet/611_BackPanel_x2_1mm_INOX.SLDPRT
cli/cad/tests/cabinet/612_SidePanel_x2_1mm_INOX.SLDPRT
cli/cad/tests/cabinet/packed/3Pos-Switch-22mm.SLDPRT
cli/cad/tests/cabinet/packed/403_MountPlate_x2_4mm_INOX.SLDPRT
cli/cad/tests/cabinet/packed/525_Belt_x1_1mm_INOX.SLDDRW
cli/cad/tests/cabinet/packed/525_Belt_x1_1mm_INOX.SLDPRT
cli/cad/tests/cabinet/packed/530_BasePost.SLDPRT
cli/cad/tests/cabinet/packed/610_FrontPanel_x1_1mm_INOX.SLDPRT
cli/cad/tests/cabinet/packed/611_BackPanel_x2_1mm_INOX.SLDPRT
cli/cad/tests/cabinet/packed/612_SidePanel_x2_1mm_INOX.SLDPRT
cli/cad/tests/cabinet/packed/E5C2.SLDPRT
cli/cad/tests/cabinet/packed/MCB-2P.SLDPRT
cli/cad/tests/cabinet/packed/Panels-Sheet-Stock-A4.SLDPRT
cli/cad/tests/cabinet/packed/Posts-14d.SLDPRT
cli/cad/tests/cas/cad/303_TriMount_x18_10mm_FERRO.SLDPRT
cli/cad/tests/cas/cad/501_FrontDoor_x2_2mm_INOX.SLDPRT
cli/cad/tests/cas/cad/502_SideDoor_x2_2mm_INOX.SLDPRT
cli/cad/tests/cas/cad/Global-CAS-Mini-Default.step
cli/cad/tests/cas/cad/Global-CAS-Mini-NoEnclosure.step
cli/cad/tests/cas/cad/Global-CAS-Mini.SLDASM
cli/cad/tests/cas/cad/Global-CAS-Mini.step
cli/cad/tests/cas/cad/Global-SPRC-A.step
cli/cad/tests/cas/cad/enclosure/102_Bottom2_x1_2mm_INOX.SLDPRT
cli/cad/tests/cas/cad/enclosure/laser/102_Top_2mm_INOX.DXF
cli/cad/tests/cas/cad/enclosure/laser/501_FrontDoor_x2_2mm_INOX.DXF
cli/cad/tests/cas/cad/enclosure/laser/502_SideDoor_x2_2mm_INOX.DXF
cli/cad/tests/cas/cad/enclosure/laser/504_BottomDoor_x2_2mm_INOX.DXF
cli/cad/tests/cas/cad/laser/200_RIBA1_x2_10mm_FERRO.DXF
cli/cad/tests/cas/cad/laser/202_PlateCover_x2_1mm_INOX2.DXF
cli/cad/tests/cas/cad/laser/302_RibMount_x8_5mm_FERRO.DXF
cli/cad/tests/cas/cad/laser/303_TriMount_x18_10mm_FERRO.DXF
cli/cad/tests/cas/cad/laser/405_BearingMount_x8_8mm_FERRO.DXF
cli/cad/tests/cas/cad/laser/6_Side_x4_5mm_FERRO.DXF
cli/cad/tests/cas/cad/laser/7_Rib_x2_5mm_FERRO.DXF
cli/cad/tests/cas/cad/laser/7_Side_x4_5mm_FERRO.DXF
cli/cad/tests/cas/cad/laser/801_EncTopMount_x4_5mm_FERRO.DXF
cli/cad/tests/cas/cad/laser/802_EncBottomMount_x4_6mm_FERRO.DXF
cli/cad/tests/cas/cad/laser/8_Rib_x2_5mm_FERRO.DXF
cli/cad/tests/cas/cad/lower-structure/100_50_Beam.SLDPRT
cli/cad/tests/cas/cad/lower-structure/100_50_BeamTop.SLDPRT
cli/cad/tests/cas/cad/press-frame-2/10_HeaterBack_x10_5mm_FERRO.DXF.SLDPRT
cli/cad/tests/cas/cad/press-frame-2/201_PlateCoverTri_x8_1mm_FERRO.SLDPRT
cli/cad/tests/cas/cad/press-frame-2/202_PlateCover_x2_1mm_INOX.SLDPRT
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
