polymech-info/heidenhain-simulator/fusion-ref/flexi-print/Z - Rail - Supports v3/Z - Rail - Supports v3_feeds_speeds.csv

Setup | Operation | Strategy | Tool | RPM | Feed | CuttingSpeed | DepthOfCut | StepOver | StepDown
Setup - Right | Drill1 (2) | drill | #4 - Ø6.7mm 90° spot drill (6.7mm Drill) | 1746.37535955874955 | 1000mmpm | tool_diameter * Math.PI * tool_spindleSpeed | tool_fluteLength / 2 | tool_diameter * 0.3 | tool_fluteLength * 0.9
Setup - Right | Drill1 (5) | drill | #4 - Ø6.7mm 90° spot drill (6.7mm Drill) | 1746.37535955874955 | 1000mmpm | tool_diameter * Math.PI * tool_spindleSpeed | tool_fluteLength / 2 | tool_diameter * 0.3 | tool_fluteLength * 0.9
Setup - Right | 2D Pocket1 | pocket2d | #15 - Ø10mm flat (10mm Flat Endmill) | 4851.04266544096845 | 551.18576986172332 | tool_diameter * Math.PI * tool_spindleSpeed | tool_fluteLength / 2 | 10. | 3.03973536813053
Setup - Right Left | Drill1 (3) | drill | #4 - Ø6.7mm 90° spot drill (6.7mm Drill) | 1746.37535955874955 | 1000mmpm | tool_diameter * Math.PI * tool_spindleSpeed | tool_fluteLength / 2 | tool_diameter * 0.3 | tool_fluteLength * 0.9
Setup - Right Left | Drill1 (6) | drill | #4 - Ø6.7mm 90° spot drill (6.7mm Drill) | 1746.37535955874955 | 1000mmpm | tool_diameter * Math.PI * tool_spindleSpeed | tool_fluteLength / 2 | tool_diameter * 0.3 | tool_fluteLength * 0.9
