polymech-info/heidenhain-simulator/fusion-ref/components/Feedscrew/900_GlobalAssembly v6/900_GlobalAssembly v6_feeds_speeds.csv

Setup | Operation | Strategy | Tool | RPM | Feed | CuttingSpeed | DepthOfCut | StepOver | StepDown
Setup1 | Face3 | face | #23 - Ø80mm face | tool_type == 'probe' ? 0 : 5000rpm | 1000. | tool_diameter * Math.PI * tool_spindleSpeed | tool_fluteLength / 2 | tool_diameter * 0.5 | 1.0mm
Setup2 | 2D Pocket1 | pocket2d | #5 - Ø10mm flat (10mm Cleaning) | 8085.07110906828348 | 3202.56334730078379 | tool_diameter * Math.PI * tool_spindleSpeed | tool_fluteLength / 2 | 12. | 4.05680655897394
Setup2 | 2D Pocket1 (2) | pocket2d | #5 - Ø9.55mm flat (10mm Cleaning) | 8085.07110906828348 | 3202.56334730078424 | tool_diameter * Math.PI * tool_spindleSpeed | tool_fluteLength / 2 | 12. | 4.05680655897394
Setup2 | Drill1 | drill | #7 - Ø11mm drill | 4158.03657037797348 | 1000mmpm | tool_diameter * Math.PI * tool_spindleSpeed | tool_fluteLength / 2 | tool_diameter * 0.5 | 1.0mm
Setup3 | 2D Pocket3 | pocket2d | #6 - Ø12mm flat (12mm Flat Endmill) | 8085.07110906828348 | 3202.56334730078424 | tool_diameter * Math.PI * tool_spindleSpeed | tool_fluteLength / 2 | 2.91817517655654 | 36.
Setup3 | 2D Pocket3 (2) | pocket2d | #6 - Ø12mm flat (12mm Flat Endmill) | 8085.07110906828348 | 3202.56334730078424 | tool_diameter * Math.PI * tool_spindleSpeed | tool_fluteLength / 2 | 2.91817517655654 | 36.
Setup3 | Drill1 (2) | drill | #7 - Ø11mm drill | 4158.03657037797348 | 1000mmpm | tool_diameter * Math.PI * tool_spindleSpeed | tool_fluteLength / 2 | tool_diameter * 0.5 | 1.0mm
Setup4 | 2D Pocket4 | pocket2d | #6 - Ø12mm flat (12mm Flat Endmill) | 8085.07110906828348 | 3202.56334730078424 | tool_diameter * Math.PI * tool_spindleSpeed | tool_fluteLength / 2 | 12. | 4.05680655897394
