polymech-info/heidenhain-simulator/cli/cad/tests/drive/400_Drive.JPG

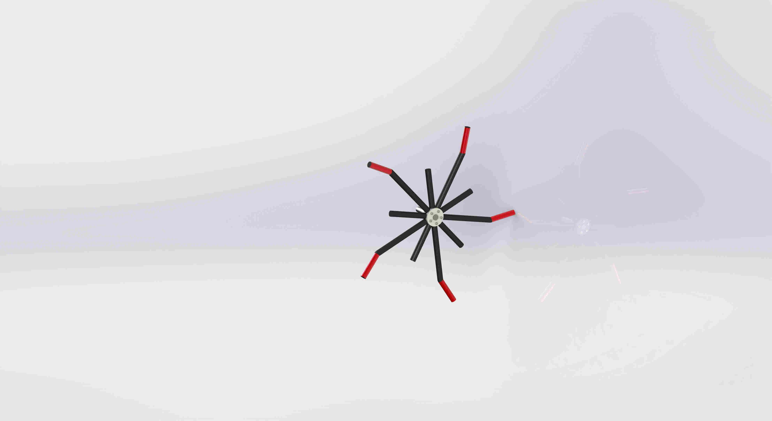
cli/cad/tests/drive/400_Drive.JPG
