polymech-info/heidenhain-simulator/fusion-ref/flexi-print/fix v4/fix v4_feeds_speeds.csv

Setup | Operation | Strategy | Tool | RPM | Feed | CuttingSpeed | DepthOfCut | StepOver | StepDown
Setup1 | 2D Contour1 | contour2d | #21 - Ø20mm flat (20mm Flat Endmill) | tool_type == 'probe' ? 0 : tool_type == 'tap right hand' || tool_type == 'tap left hand' ? 500rpm : 5000rpm | 1000. | tool_diameter * Math.PI * tool_spindleSpeed | tool_fluteLength / 2 | tool_diameter * 0.3 | tool_fluteLength * 0.9
Setup1 (2) | 2D Contour1 (2) | contour2d | #21 - Ø20mm flat (20mm Flat Endmill) | tool_type == 'probe' ? 0 : tool_type == 'tap right hand' || tool_type == 'tap left hand' ? 500rpm : 5000rpm | 1000. | tool_diameter * Math.PI * tool_spindleSpeed | tool_fluteLength / 2 | tool_diameter * 0.3 | tool_fluteLength * 0.9
Setup1 (2) | 2D Pocket1 | pocket2d | #21 - Ø20mm flat (20mm Flat Endmill) | tool_type == 'probe' ? 0 : tool_type == 'tap right hand' || tool_type == 'tap left hand' ? 500rpm : 5000rpm | 1000. | tool_diameter * Math.PI * tool_spindleSpeed | tool_fluteLength / 2 | tool_diameter * 0.3 | tool_fluteLength * 0.9
Setup1 (2) | 2D Contour2 | contour2d | #31 - Ø10mm flat (10mm Flat Endmill) | tool_type == 'probe' ? 0 : tool_type == 'tap right hand' || tool_type == 'tap left hand' ? 500rpm : 5000rpm | 1000. | tool_diameter * Math.PI * tool_spindleSpeed | tool_fluteLength / 2 | tool_diameter * 0.3 | tool_fluteLength * 0.9
Setup1 (2) | Drill2 | drill | #5 - Ø8mm drill | tool_type == 'probe' ? 0 : tool_type == 'tap right hand' || tool_type == 'tap left hand' ? 500rpm : 5000rpm | 1000mmpm | tool_diameter * Math.PI * tool_spindleSpeed | tool_fluteLength / 2 | tool_diameter * 0.3 | tool_fluteLength * 0.9
Setup1 (2) | Drill1 (2) | drill | #13 - Ø10mm drill (M2) | 500. | 1000mmpm | tool_diameter * Math.PI * tool_spindleSpeed | tool_fluteLength / 2 | tool_diameter * 0.3 | tool_fluteLength * 0.9
Setup1 (3) | 2D Pocket2 | pocket2d | #31 - Ø10mm flat (10mm Flat Endmill) | tool_type == 'probe' ? 0 : tool_type == 'tap right hand' || tool_type == 'tap left hand' ? 500rpm : 5000rpm | 1000. | tool_diameter * Math.PI * tool_spindleSpeed | tool_fluteLength / 2 | tool_diameter * 0.3 | tool_fluteLength * 0.9
Setup1 (3) | 2D Pocket2 (2) | pocket2d | #31 - Ø10mm flat (10mm Flat Endmill) | tool_type == 'probe' ? 0 : tool_type == 'tap right hand' || tool_type == 'tap left hand' ? 500rpm : 5000rpm | 1000. | tool_diameter * Math.PI * tool_spindleSpeed | tool_fluteLength / 2 | tool_diameter * 0.3 | tool_fluteLength * 0.9
Setup1 (3) | Probe WCS1 | probe | #100 - Ø6mm probe (TS640 50x6) |  | 1000mmpm |  | tool_fluteLength / 2 | tool_diameter * 0.3 | tool_fluteLength * 0.9
Setup1 (3) | Drill1 | drill | #13 - Ø10mm drill (M2) | 500. | 1000mmpm | tool_diameter * Math.PI * tool_spindleSpeed | tool_fluteLength / 2 | tool_diameter * 0.3 | tool_fluteLength * 0.9
