polymech-info/heidenhain-simulator/cli/cad/tests/drive/400_Drive.pdf

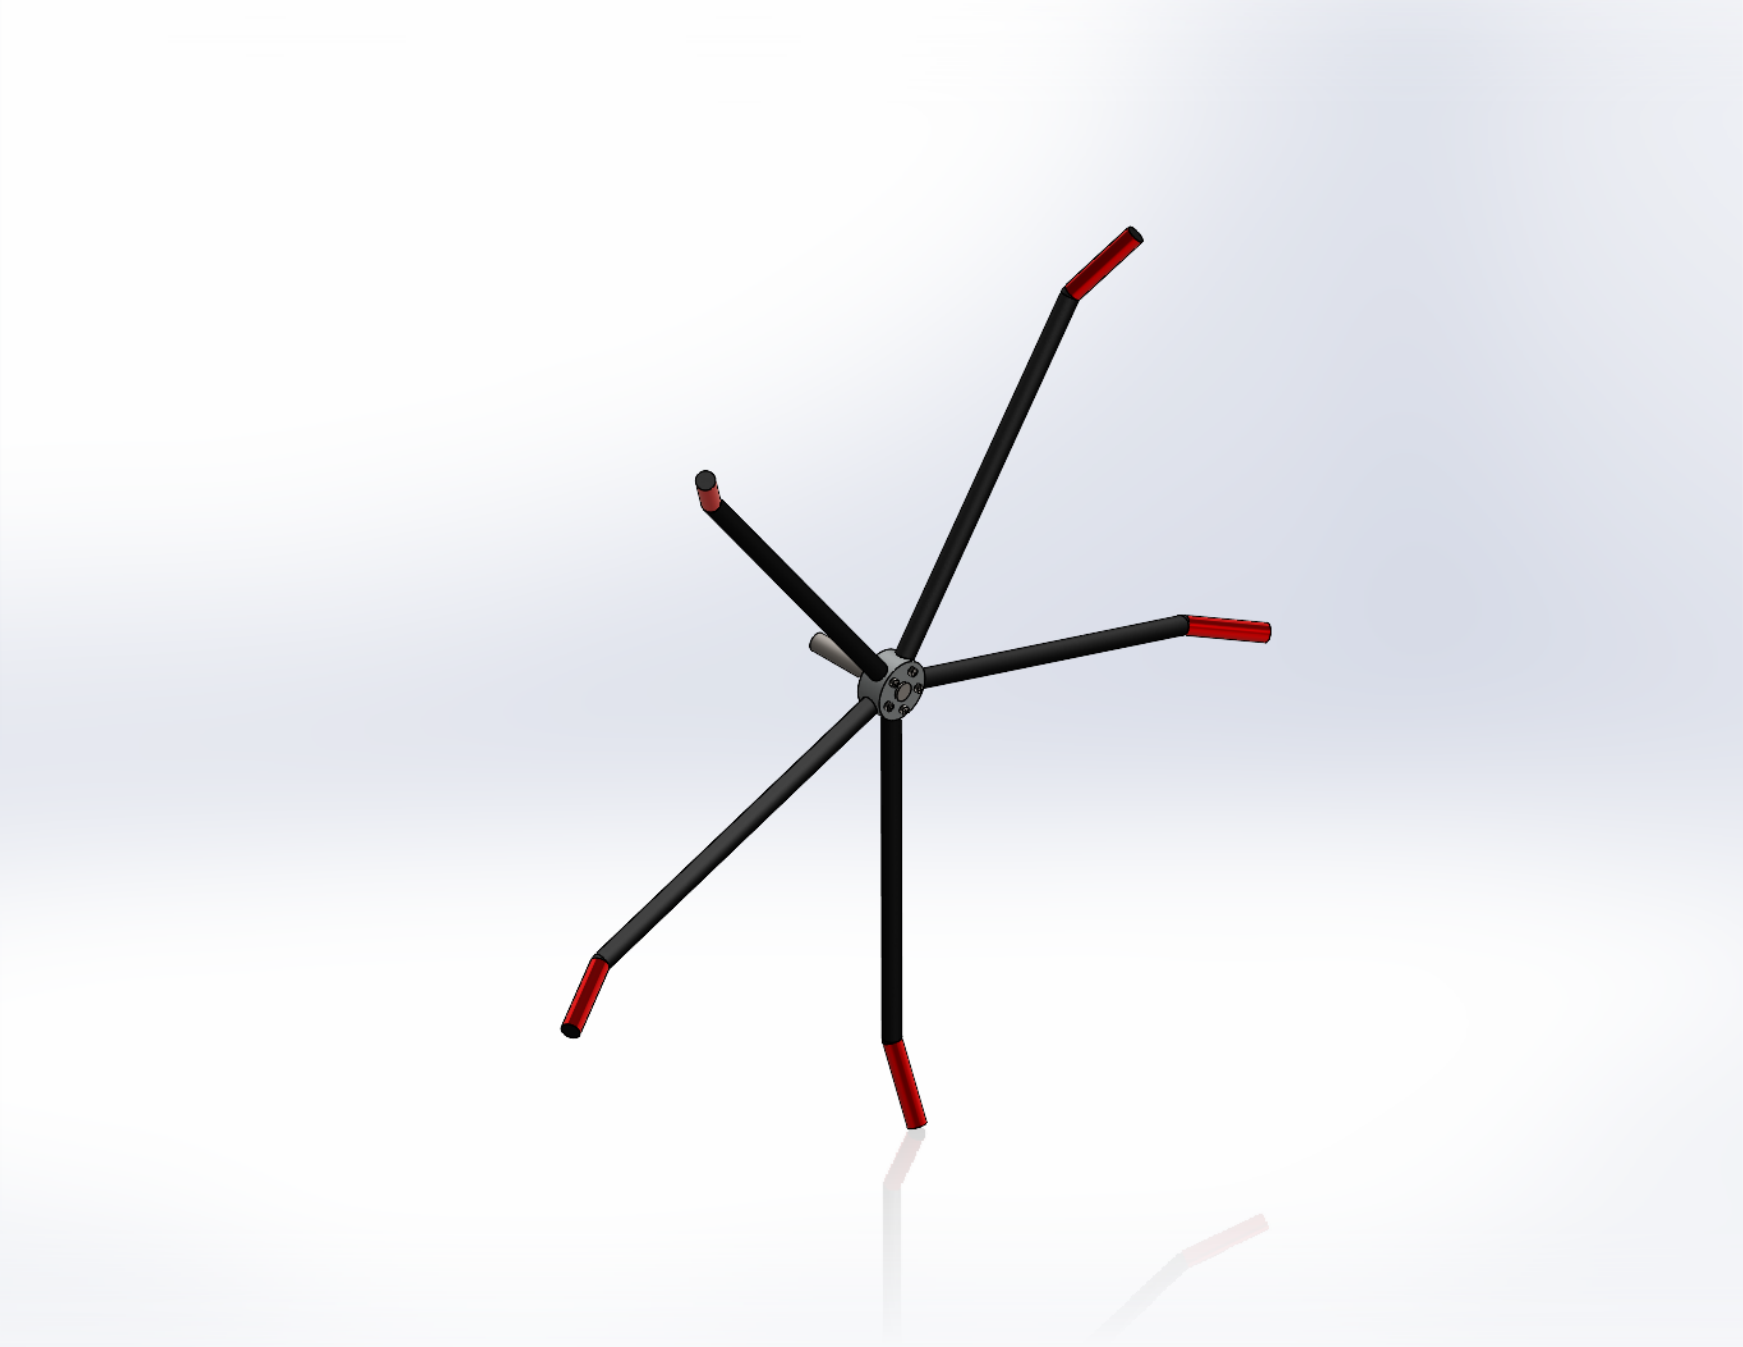
[picture p89: page 1]
