polymech-info/heidenhain-simulator/(commit log)

2026-09-25 bootstrap files
    [0.75 KW 60_1 AC motor v1.f3d, 0.75 KW 60_1 AC motor v1.step, 1000-plate v1.f3d, 1000-plate v1.step, 100_50_Beam.SLDPRT, 100_50_BeamBottom.SLDPRT, 100_50_BeamTop.SLDPRT, 102_Bottom2_x1_2mm_INOX.DXF]
2026-09-25 sim v1
    [siat.step, siat_ws212_palette_wrapper_adjustable.scad]
